Edgeworth/memepu/docs/parts.txt

74HC00 - NAND gate
74HC02 - NOR gate
74HC04 - NOT gate
74HC08 - AND gate
74HC32 - OR gate
74HC74 - D flipflop
74HC86 - XOR gate
74HC107 - Dual JK flipflop with reset, negative edge trigger.
74HC138 - 3 to 8 decoder, inverted outputs
74HC139 - 2 to 4 decoder, inverted outputs
74HC151 - 8-line to 1-line data selector/multiplexer
74HC153 - Dual 4-input data selector/multiplexer
74HC154 - 4 to 16 decoder, inverted outputs
74HC157 - select 4 bits from two data sources
74HC161 - 4 bit binary counter, synchronous, async reset
74HC193 - 4 bit binary counter, up/down, synchronous, reset
74HC238 - 3 to 8 decoder
74HC245 - Octal bidirectional bus transceiver
74HC254 - 4 to 16 decoder, inverting outputs
74HC273 - 8 bit register, asynchronous clear, bad pinout
74HC283 - 4 bit binary full adder
74HC574 - 8 bit register
74HC590 - 8 bit binary counter, tri-state
74HC595 - 8 bit shift register

Digikey costs:
x8 SRAM cost per MiB, minimum quantity 1 order, <= 10ns access time:
  32 KiB: $41.6
  128 KiB: $13.44
  256 KiB: $18.32
  512 KiB: $6.4 *
  1 MiB: $13.49
  2 MiB: $11.09

x16 SRAM cost per MiB, minimum quantity 1 order, <= 10ns access time:
  128 KiB: $14.72
  256 KiB: $11.96
  512 KiB: $5.98 *
  1 MiB: $13.14
  2 MiB: $7.87
  4 MiB: $6.375
  8 MiB: $26.75

x32 SRAM cost per MiB, minimum quantity 1 order, <= 10ns access time:
  256 KiB: $27.68
  512 MiB: $11.74
  1 MiB: $8.90 *
  2 MiB: $8.95
  4 MiB: $15
  8 MiB: $19

SDRAM: Can just buy SDRAM module off ebay?
x8 SDRAM cost per MiB, minimum quantity 1 order:
  16 MiB: $0.16
  32 MiB: $0.113
  64 MiB: $0.217

x16 SDRAM cost per MiB, minimum quantity 1 order:
  16 MiB: $0.12
  32 MiB: $0.076 *
  64 MiB: $0.20

x32 SDRAM cost per MiB, minimum quantity 1 order:
  16 MiB: $0.15
  32 MiB: $0.22
  64 MiB: $0.312

Voltage translation ICs:
GTL2003, GTL2010, GTL2000: 8 bit, 10 bit, 22 bit bi-directional translator
TXS0108: (TXB is not open-drain) 8 bit

Notes:
Arduino Nano notes:
Digital pins 0, 1 used for USB - can't use them at the same time
D13: LED
A6, 7: Can't be used as digital pins

Chips:
LM555:
Pins: Trigger, Threshold, Output, Reset, Discharge, Control voltage
Trigger: On below 1/3 * Vcc - sets SR latch and turns output on
Threshold: Once reach 2/3 * Vcc or more - resets SR latch and turns output off. Additionally connects discharge pin to ground to discharge capacitor
Reset: Disable/resets the timer. Active low. Should be set high.
Discharge: Capacitor discharges through this
Control voltage: Can modify the 2/3 * Vcc threshold value. Usually connected to ground via a bypass cap.

74HC08 - AND gate

74HC138 - 3-8 line decoder
~E1, ~E2, E3: set to enable

74HC154 - 4 to 16 line decoder:
~E1,~E2: enable inputs, tie these both low. I guess they had extra pins?

74HC161 - 4 bit synchronous counter
CEP: count enable - both CEP and CET need to be true to count
CET: input for chaining, TC => CET
TC: output for chaining. True if at highest count and about to roll-over, AND CET is high.
~PE: parallel enable input - for pre-setting values
~MR: resets all to 0, asynchronous

74HC595 - 8 bit shift register
Has a shift register and a storage register. Pulsing SRCLK reads data from SER. Pulsing RCLK outputs data from shift register onto output.
Q(a-h): Output
SER: Input bit for shifting
Qh': Output bit that comes off during a shift
SRCLK: Shift register clock (positive edge)
RCLK: Register clock (positive edge)

Functional units:
Clock:
555 timer for astable multivibrator for clock
555 timer for monostable multivibrator for manual clock
555 timer for bistable multivibrator for switch debouncing

Microop counter 74HC161:
CEP, CET: HIGH so always counts
TC: unconnected
~PE: disabled
~MR: For resetting micro op counter

Control EEPROM #2:
Input: Opcode(8), Microop counter(4)
4 pins: OUT control plane
4 pins: IN control plane
