Edgeworth/memepu/pcb/cpu/cpu.kicad_pcb

## KiCad design pcb/cpu/cpu.kicad_pcb (2021-06-20)

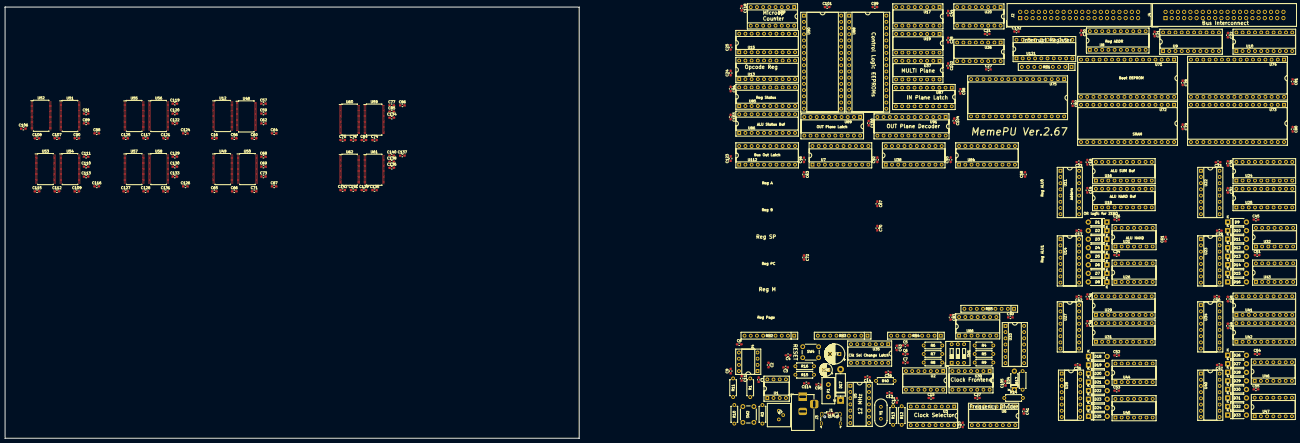
[picture p1: board cpu.kicad_pcb from above]

Board: 2 copper layers, 235.0 x 176.5 mm, 286 parts (0 on the bottom side), 340 nets, no tracks yet.

Parts:
C1, C5, C6, C7, C9, C10, C11, C14, C15, C16, C17, C18, C19, C20, C21, C22, C23, C24, C25, C26, C27, C28, C29, C30, C31, C32, C33, C34, C35, C36, C37, C38, C40, C41, C42, C43, C44, C45, C46, C47, C48, C49, C50, C51, C52, C53, C54, C55, C56, C57, C58, C59, C60, C61, C62, C63, C64, C65, C66, C67, C68, C69, C70, C71, C72, C73, C74, C75, C76, C77, C78, C79, C80, C81, C82, C83, C84, C85, C86, C87, C88, C89, C90, C91, C92, C93, C94, C98, C99, C100, C101, C102, C103, C104, C106, C107, C108, C109, C110, C111, C112, C113, C114, C115, C116, C117, C118, C119, C120, C121, C122, C123, C124, C125, C126, C127, C128, C129, C130, C131, C132, C133, C134, C135, C136, C137, C138, C139, C140, C141, C142: 0.1uF; C_0603_1608Metric_Pad1.05x0.95mm_HandSolder
C2, C3: 1uF; C_0603_1608Metric_Pad1.05x0.95mm_HandSolder
C4, C8, C105: 10nF; C_0603_1608Metric_Pad1.05x0.95mm_HandSolder
C12, C13: 27pF; C_0603_1608Metric_Pad1.05x0.95mm_HandSolder
C39: 1nF; C_0603_1608Metric_Pad1.05x0.95mm_HandSolder
C95: 10uF; C_0603_1608Metric_Pad1.05x0.95mm_HandSolder
C96: 100uF; CP_Radial_D5.0mm_P2.00mm
C97: 470uF; CP_Radial_D8.0mm_P3.80mm
D1, D2, D3, D4, D5, D6, D7, D8, D9, D10, D11, D12, D13, D14, D15, D16, D18, D19, D20, D21, D22, D23, D24, D25, D26, D27, D28, D29, D30, D31, D32, D33, D34: D; D_DO-41_SOD81_P7.62mm_Horizontal
D17: 5.6V; D_5W_P12.70mm_Horizontal
F1: 0.65A; C_Disc_D10.5mm_W5.0mm_P5.00mm
J1: Conn_01x05; USB_Micro-B_Wuerth_629105150521
J2, J4: Conn_02x20_Odd_Even; IDC-Header_2x20_P2.54mm_Vertical
J3: Conn_01x03; BarrelJack_Horizontal
R1, R3, R13: 1K; R_Axial_DIN0207_L6.3mm_D2.5mm_P7.62mm_Horizontal
R2: 1M; Akizuki-Denshi Potentiometer
R4, R5, R9, R10, R14, R15: 100K; R_Axial_DIN0207_L6.3mm_D2.5mm_P7.62mm_Horizontal
R6, R7, R8, R11, R12, R16, R17, R40: 1M; R_Axial_DIN0207_L6.3mm_D2.5mm_P7.62mm_Horizontal
RN1: 10K; R_Array_SIP9
RN2, RN3, RN4, RN5: 100K; R_Array_SIP9
SW1: SW_DIP_x03 - Clock Source Select; SW_DIP_SPSTx03_Slide_9.78x9.8mm_W7.62mm_P2.54mm
SW2, SW4: SW_Push; SW_PUSH_6mm_H7.3mm
U1: LM555; DIP-8_W7.62mm_Socket
U2: 74HC14; DIP-14_W7.62mm_Socket
U3: 74151; DIP-16_W7.62mm_Socket
U4: LM555 - Button Clock; DIP-8_W7.62mm_Socket
U5: 74HC04; DIP-14_W7.62mm_Socket
U6, U39: 74HC590; DIP-16_W7.62mm_Socket
U7, U38, U84, U87, U89, U112: 74LS574; DIP-20_W7.62mm_Socket
U8, U9, U10, U85, U121: 74HCT574; DIP-20_W7.62mm_Socket
U11, U14, U22, U23, U27, U28, U34, U40: 74LS283; DIP-16_W7.62mm_Socket
U12, U48, U49, U50, U51, U52, U53, U54, U55, U56, U57, U58, U59, U60, U61, U62: SN74LVC16374DL; TSSOP-48_6.1x12.5mm_P0.5mm
U13, U15: 74LS273; DIP-20_W7.62mm_Socket
U16, U18, U24, U25, U29, U31, U41, U42, U86: 74HC245; DIP-20_W7.62mm_Socket
U17, U19, U20, U36: 74HC238; DIP-16_W7.62mm_Socket
U21, U26, U32, U43, U44, U45, U46, U47: 74HC00; DIP-14_W7.62mm_Socket
U30: 74HC86; DIP-14_W7.62mm_Socket
U33: 74LS08; DIP-14_W7.62mm_Socket
U35: 74LS107; DIP-14_W7.62mm_Socket
U37: 74LS138; DIP-16_W7.62mm_Socket
U66: 74LS32; DIP-14_W7.62mm_Socket
U71, U88, U90: SST39SF040; DIP-32_W15.24mm_Socket
U72, U73, U74, U75: 628128; DIP-32_W15.24mm_Socket
U91: 74LS154; DIP-24_W7.62mm_Socket
Y1: 12MHz; Crystal_HC49-U_Vertical

Connections:
/ADDR0: J2.29, U8.19, U71.12
/ADDR1: J2.31, U8.18, U71.11
/ADDR2: J2.33, U8.17, U71.10, U72.12, U73.12, U74.12, U75.12
/ADDR3: J2.35, U8.16, U71.9, U72.11, U73.11, U74.11, U75.11
/ADDR4: J2.37, U8.15, U71.8, U72.10, U73.10, U74.10, U75.10
/ADDR5: J2.39, U8.14, U71.7, U72.9, U73.9, U74.9, U75.9
/ADDR6: J4.1, U8.13, U71.6, U72.8, U73.8, U74.8, U75.8
/ADDR7: J4.3, U8.12, U71.5, U72.7, U73.7, U74.7, U75.7
/ADDR8: J4.5, U9.19, U71.27, U72.6, U73.6, U74.6, U75.6
/ADDR9: J4.7, U9.18, U71.26, U72.5, U73.5, U74.5, U75.5
/ADDR10: J4.9, U9.17, U71.23, U72.27, U73.27, U74.27, U75.27
/ADDR11: J4.11, U9.16, U71.25, U72.26, U73.26, U74.26, U75.26
/ADDR12: J4.13, U9.15, U71.4, U72.23, U73.23, U74.23, U75.23
/ADDR13: J4.15, U9.14, U71.28, U72.25, U73.25, U74.25, U75.25
/ADDR14: J4.17, U9.13, U71.29, U72.4, U73.4, U74.4, U75.4
/ADDR15: J4.19, U9.12, U71.3, U72.28, U73.28, U74.28, U75.28
/ADDR16: J4.21, U10.19, U71.2, U72.3, U73.3, U74.3, U75.3
/ADDR17: J4.23, U10.18, U71.30, U72.31, U73.31, U74.31, U75.31
/ADDR18: J4.25, U10.17, U71.1, U72.2, U73.2, U74.2, U75.2
/ADDR19: J4.27, U10.16
/ADDR20: J4.29, U10.15
/ADDR21: J4.31, U10.14
/ADDR22: J4.33, U10.13, U72.22, U73.22, U74.22, U75.22
/ADDR23: J4.35, U10.12, U72.30, U73.30, U74.30, U75.30
/ADDR_IN_CLK: U8.11, U9.11, U10.11, U17.7
/ALU0_IN_CLK: U12.25, U12.48, U17.10, U48.25, U48.48
/ALU1_IN_CLK: U17.9, U49.25, U49.48, U50.25, U50.48
/ALU/A0: D1.2, U11.5, U12.2, U21.1
/ALU/A1: D2.2, U11.3, U12.3, U21.4
/ALU/A2: D3.2, U11.14, U12.5, U21.9
/ALU/A3: D4.2, U11.12, U12.6, U21.12
/ALU/A4: D5.2, U12.8, U14.5, U26.1
/ALU/A5: D6.2, U12.9, U14.3, U26.4
/ALU/A6: D7.2, U12.11, U14.14, U26.9
/ALU/A7: D8.2, U12.12, U14.12, U26.12
/ALU/A8: D9.2, U12.13, U22.5, U32.1
/ALU/A9: D10.2, U12.14, U22.3, U32.4
/ALU/A10: D11.2, U12.16, U22.14, U32.9
/ALU/A11: D12.2, U12.17, U22.12, U32.12
/ALU/A12: D13.2, U12.19, U23.5, U43.1
/ALU/A13: D14.2, U12.20, U23.3, U43.4
/ALU/A14: D15.2, U12.22, U23.14, U43.9
/ALU/A15: D16.2, U12.23, U23.12, U43.12
/ALU/A16: D18.2, U27.5, U44.1, U48.2
/ALU/A17: D19.2, U27.3, U44.4, U48.3
/ALU/A18: D20.2, U27.14, U44.9, U48.5
/ALU/A19: D21.2, U27.12, U44.12, U48.6
/ALU/A20: D22.2, U28.5, U45.1, U48.8
/ALU/A21: D23.2, U28.3, U45.4, U48.9
/ALU/A22: D24.2, U28.14, U45.9, U48.11
/ALU/A23: D25.2, U28.12, U45.12, U48.12
/ALU/A24: D26.2, U34.5, U46.1, U48.13
/ALU/A25: D27.2, U34.3, U46.4, U48.14
/ALU/A26: D28.2, U34.14, U46.9, U48.16
/ALU/A27: D29.2, U34.12, U46.12, U48.17
/ALU/A28: D30.2, U40.5, U47.1, U48.19
/ALU/A29: D31.2, U40.3, U47.4, U48.20
/ALU/A30: D32.2, U40.14, U47.9, U48.22
/ALU/A31: D33.2, U40.12, U47.12, U48.23
/ALU/B0: U11.6, U21.2, U49.2
/ALU/B1: U11.2, U21.5, U49.3
/ALU/B2: U11.15, U21.10, U49.5
/ALU/B3: U11.11, U21.13, U49.6
/ALU/B4: U14.6, U26.2, U49.8
/ALU/B5: U14.2, U26.5, U49.9
/ALU/B6: U14.15, U26.10, U49.11
/ALU/B7: U14.11, U26.13, U49.12
/ALU/B8: U22.6, U32.2, U49.13
/ALU/B9: U22.2, U32.5, U49.14
/ALU/B10: U22.15, U32.10, U49.16
/ALU/B11: U22.11, U32.13, U49.17
/ALU/B12: U23.6, U43.2, U49.19
/ALU/B13: U23.2, U43.5, U49.20
/ALU/B14: U23.15, U43.10, U49.22
/ALU/B15: U23.11, U43.13, U49.23
/ALU/B16: U27.6, U44.2, U50.2
/ALU/B17: U27.2, U44.5, U50.3
/ALU/B18: U27.15, U44.10, U50.5
/ALU/B19: U27.11, U44.13, U50.6
/ALU/B20: U28.6, U45.2, U50.8
/ALU/B21: U28.2, U45.5, U50.9
/ALU/B22: U28.15, U45.10, U50.11
/ALU/B23: U28.11, U45.13, U50.12
/ALU/B24: U34.6, U46.2, U50.13
/ALU/B25: U34.2, U46.5, U50.14
/ALU/B26: U34.15, U46.10, U50.16
/ALU/B27: U34.11, U46.13, U50.17
/ALU/B28: U40.6, U47.2, U50.19
/ALU/B29: U40.2, U47.5, U50.20
/ALU/B30: U40.15, U47.10, U50.22
/ALU/B31: U40.11, U47.13, U50.23
/ALU/CARRY0: U11.9, U14.7
/ALU/CARRY1: U14.9, U22.7
/ALU/CARRY2: U22.9, U23.7
/ALU/CARRY3: U23.9, U27.7
/ALU/CARRY4: U27.9, U28.7
/ALU/CARRY5: U28.9, U34.7
/ALU/CARRY6: U34.9, U40.7
/ALU/CARRY_OUT: U40.9, U86.2
/ALU/NAND0: U18.2, U21.3
/ALU/NAND1: U18.3, U21.6
/ALU/NAND2: U18.4, U21.8
/ALU/NAND3: U18.5, U21.11
/ALU/NAND4: U18.6, U26.3
/ALU/NAND5: U18.7, U26.6
/ALU/NAND6: U18.8, U26.8
/ALU/NAND7: U18.9, U26.11
/ALU/NAND8: U25.2, U32.3
/ALU/NAND9: U25.3, U32.6
/ALU/NAND10: U25.4, U32.8
/ALU/NAND11: U25.5, U32.11
/ALU/NAND12: U25.6, U43.3
/ALU/NAND13: U25.7, U43.6
/ALU/NAND14: U25.8, U43.8
/ALU/NAND15: U25.9, U43.11
/ALU/NAND16: U31.2, U44.3
/ALU/NAND17: U31.3, U44.6
/ALU/NAND18: U31.4, U44.8
/ALU/NAND19: U31.5, U44.11
/ALU/NAND20: U31.6, U45.3
/ALU/NAND21: U31.7, U45.6
/ALU/NAND22: U31.8, U45.8
/ALU/NAND23: U31.9, U45.11
/ALU/NAND24: U42.2, U46.3
/ALU/NAND25: U42.3, U46.6
/ALU/NAND26: U42.4, U46.8
/ALU/NAND27: U42.5, U46.11
/ALU/NAND28: U42.6, U47.3
/ALU/NAND29: U42.7, U47.6
/ALU/NAND30: U42.8, U47.8
/ALU/NAND31: U42.9, U47.11
/ALU/SUM0: U11.4, U16.2
/ALU/SUM1: U11.1, U16.3
/ALU/SUM2: U11.13, U16.4
/ALU/SUM3: U11.10, U16.5
/ALU/SUM4: U14.4, U16.6
/ALU/SUM5: U14.1, U16.7
/ALU/SUM6: U14.13, U16.8
/ALU/SUM7: U14.10, U16.9
/ALU/SUM8: U22.4, U24.2
/ALU/SUM9: U22.1, U24.3
/ALU/SUM10: U22.13, U24.4
/ALU/SUM11: U22.10, U24.5
/ALU/SUM12: U23.4, U24.6
/ALU/SUM13: U23.1, U24.7
/ALU/SUM14: U23.13, U24.8
/ALU/SUM15: U23.10, U24.9
/ALU/SUM16: U27.4, U29.2
/ALU/SUM17: U27.1, U29.3
/ALU/SUM18: U27.13, U29.4
/ALU/SUM19: U27.10, U29.5
/ALU/SUM20: U28.4, U29.6
/ALU/SUM21: U28.1, U29.7
/ALU/SUM22: U28.13, U29.8
/ALU/SUM23: U28.10, U29.9
/ALU/SUM24: U34.4, U41.2
/ALU/SUM25: U34.1, U41.3
/ALU/SUM26: U34.13, U41.4
/ALU/SUM27: U34.10, U41.5
/ALU/SUM28: U40.4, U41.6
/ALU/SUM29: U40.1, U41.7
/ALU/SUM30: U40.13, U41.8
/ALU/SUM31: U40.10, U41.9
/ALU/ZERO_OUT: U2.8, U86.3
/A_IN_CLK: U17.14, U51.25, U51.48, U52.25, U52.48
/BUS0: J2.2, RN2.9, U8.2, U12.47, U13.3, U15.3, U16.18, U18.18, U49.47, U51.2, U51.47, U53.2, U53.47, U55.2, U55.47, U57.2, U57.47, U59.2, U59.47, U61.2, U61.47, U71.13, U72.13, U85.2, U85.19, U86.18, U112.19, U121.19
/BUS1: J2.4, RN2.8, U8.3, U12.46, U13.4, U15.4, U16.17, U18.17, U49.46, U51.3, U51.46, U53.3, U53.46, U55.3, U55.46, U57.3, U57.46, U59.3, U59.46, U61.3, U61.46, U71.14, U72.14, U85.3, U85.18, U86.17, U112.18, U121.18
/BUS2: J2.6, RN2.7, U8.4, U12.44, U13.7, U15.7, U16.16, U18.16, U49.44, U51.5, U51.44, U53.5, U53.44, U55.5, U55.44, U57.5, U57.44, U59.5, U59.44, U61.5, U61.44, U71.15, U72.15, U85.4, U85.17, U86.16, U112.17, U121.17
/BUS3: J2.8, RN2.6, U8.5, U12.43, U13.8, U15.8, U16.15, U18.15, U49.43, U51.6, U51.43, U53.6, U53.43, U55.6, U55.43, U57.6, U57.43, U59.6, U59.43, U61.6, U61.43, U71.17, U72.17, U85.5, U85.16, U86.15, U112.16, U121.16
/BUS4: J2.10, RN2.5, U8.6, U12.41, U13.13, U15.13, U16.14, U18.14, U49.41, U51.8, U51.41, U53.8, U53.41, U55.8, U55.41, U57.8, U57.41, U59.8, U59.41, U61.8, U61.41, U71.18, U72.18, U85.6, U85.15, U86.14, U112.15, U121.15
/BUS5: J2.12, RN2.4, U8.7, U12.40, U13.14, U15.14, U16.13, U18.13, U49.40, U51.9, U51.40, U53.9, U53.40, U55.9, U55.40, U57.9, U57.40, U59.9, U59.40, U61.9, U61.40, U71.19, U72.19, U85.7, U85.14, U86.13, U112.14, U121.14
/BUS6: J2.14, RN2.3, U8.8, U12.38, U13.17, U15.17, U16.12, U18.12, U49.38, U51.11, U51.38, U53.11, U53.38, U55.11, U55.38, U57.11, U57.38, U59.11, U59.38, U61.11, U61.38, U71.20, U72.20, U85.8, U85.13, U86.12, U112.13, U121.13
/BUS7: J2.16, RN2.2, U8.9, U12.37, U13.18, U15.18, U16.11, U18.11, U49.37, U51.12, U51.37, U53.12, U53.37, U55.12, U55.37, U57.12, U57.37, U59.12, U59.37, U61.12, U61.37, U71.21, U72.21, U85.9, U85.12, U86.11, U112.12, U121.12
/BUS8: J2.18, RN3.9, U7.19, U9.2, U12.36, U24.18, U25.18, U49.36, U51.13, U51.36, U53.13, U53.36, U55.13, U55.36, U57.13, U57.36, U59.13, U59.36, U61.13, U61.36, U73.13
/BUS9: J2.20, RN3.8, U7.18, U9.3, U12.35, U24.17, U25.17, U49.35, U51.14, U51.35, U53.14, U53.35, U55.14, U55.35, U57.14, U57.35, U59.14, U59.35, U61.14, U61.35, U73.14
/BUS10: J2.22, RN3.7, U7.17, U9.4, U12.33, U24.16, U25.16, U49.33, U51.16, U51.33, U53.16, U53.33, U55.16, U55.33, U57.16, U57.33, U59.16, U59.33, U61.16, U61.33, U73.15
/BUS11: J2.24, RN3.6, U7.16, U9.5, U12.32, U24.15, U25.15, U49.32, U51.17, U51.32, U53.17, U53.32, U55.17, U55.32, U57.17, U57.32, U59.17, U59.32, U61.17, U61.32, U73.17
/BUS12: J2.26, RN3.5, U7.15, U9.6, U12.30, U24.14, U25.14, U49.30, U51.19, U51.30, U53.19, U53.30, U55.19, U55.30, U57.19, U57.30, U59.19, U59.30, U61.19, U61.30, U73.18
/BUS13: J2.28, RN3.4, U7.14, U9.7, U12.29, U24.13, U25.13, U49.29, U51.20, U51.29, U53.20, U53.29, U55.20, U55.29, U57.20, U57.29, U59.20, U59.29, U61.20, U61.29, U73.19
/BUS14: J2.30, RN3.3, U7.13, U9.8, U12.27, U24.12, U25.12, U49.27, U51.22, U51.27, U53.22, U53.27, U55.22, U55.27, U57.22, U57.27, U59.22, U59.27, U61.22, U61.27, U73.20
/BUS15: J2.32, RN3.2, U7.12, U9.9, U12.26, U24.11, U25.11, U49.26, U51.23, U51.26, U53.23, U53.26, U55.23, U55.26, U57.23, U57.26, U59.23, U59.26, U61.23, U61.26, U73.21
/BUS16: J2.34, RN4.9, U10.2, U29.18, U31.18, U38.19, U48.47, U50.47, U52.2, U52.47, U54.2, U54.47, U56.2, U56.47, U58.2, U58.47, U60.2, U60.47, U62.2, U62.47, U74.13
/BUS17: J2.36, RN4.8, U10.3, U29.17, U31.17, U38.18, U48.46, U50.46, U52.3, U52.46, U54.3, U54.46, U56.3, U56.46, U58.3, U58.46, U60.3, U60.46, U62.3, U62.46, U74.14
/BUS18: J2.38, RN4.7, U10.4, U29.16, U31.16, U38.17, U48.44, U50.44, U52.5, U52.44, U54.5, U54.44, U56.5, U56.44, U58.5, U58.44, U60.5, U60.44, U62.5, U62.44, U74.15
/BUS19: J2.40, RN4.6, U10.5, U29.15, U31.15, U38.16, U48.43, U50.43, U52.6, U52.43, U54.6, U54.43, U56.6, U56.43, U58.6, U58.43, U60.6, U60.43, U62.6, U62.43, U74.17
/BUS20: J4.2, RN4.5, U10.6, U29.14, U31.14, U38.15, U48.41, U50.41, U52.8, U52.41, U54.8, U54.41, U56.8, U56.41, U58.8, U58.41, U60.8, U60.41, U62.8, U62.41, U74.18
/BUS21: J4.4, RN4.4, U10.7, U29.13, U31.13, U38.14, U48.40, U50.40, U52.9, U52.40, U54.9, U54.40, U56.9, U56.40, U58.9, U58.40, U60.9, U60.40, U62.9, U62.40, U74.19
/BUS22: J4.6, RN4.3, U10.8, U29.12, U31.12, U38.13, U48.38, U50.38, U52.11, U52.38, U54.11, U54.38, U56.11, U56.38, U58.11, U58.38, U60.11, U60.38, U62.11, U62.38, U74.20
/BUS23: J4.8, RN4.2, U10.9, U29.11, U31.11, U38.12, U48.37, U50.37, U52.12, U52.37, U54.12, U54.37, U56.12, U56.37, U58.12, U58.37, U60.12, U60.37, U62.12, U62.37, U74.21
/BUS24: J4.10, RN5.9, U41.18, U42.18, U48.36, U50.36, U52.13, U52.36, U54.13, U54.36, U56.13, U56.36, U58.13, U58.36, U60.13, U60.36, U62.13, U62.36, U75.13, U84.19
/BUS25: J4.12, RN5.8, U41.17, U42.17, U48.35, U50.35, U52.14, U52.35, U54.14, U54.35, U56.14, U56.35, U58.14, U58.35, U60.14, U60.35, U62.14, U62.35, U75.14, U84.18
/BUS26: J4.14, RN5.7, U41.16, U42.16, U48.33, U50.33, U52.16, U52.33, U54.16, U54.33, U56.16, U56.33, U58.16, U58.33, U60.16, U60.33, U62.16, U62.33, U75.15, U84.17
/BUS27: J4.16, RN5.6, U41.15, U42.15, U48.32, U50.32, U52.17, U52.32, U54.17, U54.32, U56.17, U56.32, U58.17, U58.32, U60.17, U60.32, U62.17, U62.32, U75.17, U84.16
/BUS28: J4.18, RN5.5, U41.14, U42.14, U48.30, U50.30, U52.19, U52.30, U54.19, U54.30, U56.19, U56.30, U58.19, U58.30, U60.19, U60.30, U62.19, U62.30, U75.18, U84.15
/BUS29: J4.20, RN5.4, U41.13, U42.13, U48.29, U50.29, U52.20, U52.29, U54.20, U54.29, U56.20, U56.29, U58.20, U58.29, U60.20, U60.29, U62.20, U62.29, U75.19, U84.14
/BUS30: J4.22, RN5.3, U41.12, U42.12, U48.27, U50.27, U52.22, U52.27, U54.22, U54.27, U56.22, U56.27, U58.22, U58.27, U60.22, U60.27, U62.22, U62.27, U75.20, U84.13
/BUS31: J4.24, RN5.2, U41.11, U42.11, U48.26, U50.26, U52.23, U52.26, U54.23, U54.26, U56.23, U56.26, U58.23, U58.26, U60.23, U60.26, U62.23, U62.26, U75.21, U84.12
/B_IN_CLK: U17.13, U53.25, U53.48, U54.25, U54.48
/CARRY_IN: U11.7, U37.12
/CLK: J2.5, U5.13, U17.6, U33.3, U39.11, U39.13
/Clock/1.5MHZ_CLK: U3.1, U6.2
/Clock/3MHZ_CLK: U3.2, U6.1
/Clock/6MHZ_CLK: U3.3, U6.15
/Clock/12MHZ_CLK: U3.4, U5.4, U6.11, U6.13
/Clock/47_KHZ_CLK: U3.14, U6.7
/Clock/187KHZ_CLK: U3.15, U6.5
/Clock/AC_TR: C3.1, R2.2, U1.2, U1.6
/Clock/ADJ_CLK: U1.3, U3.13
/Clock/BTN_CLK: U3.12, U4.3
/Clock/PRE_CLK: U3.5, U33.10, U35.9
/Clock/SEL0: U2.2, U3.11, U30.1
/Clock/SEL1: U2.4, U3.10, U30.2
/Clock/SEL2: U2.6, U3.9, U30.12
/Control Logic/CTRL0: U87.2, U88.13
/Control Logic/CTRL1: U87.3, U88.14
/Control Logic/CTRL2: U87.4, U88.15
/Control Logic/CTRL3: U87.5, U88.17
/Control Logic/CTRL4: U87.6, U88.18
/Control Logic/CTRL5: U87.7, U88.19
/Control Logic/CTRL6: U87.8, U88.20
/Control Logic/CTRL7: U87.9, U88.21
/Control Logic/CTRL8: U7.2, U38.2, U84.2, U89.2, U90.13, U112.2
/Control Logic/CTRL9: U7.3, U38.3, U84.3, U89.3, U90.14, U112.3
/Control Logic/CTRL10: U7.4, U38.4, U84.4, U89.4, U90.15, U112.4
/Control Logic/CTRL11: U7.5, U38.5, U84.5, U89.5, U90.17, U112.5
/Control Logic/CTRL12: U7.6, U38.6, U84.6, U89.6, U90.18, U112.6
/Control Logic/CTRL13: U7.7, U38.7, U84.7, U89.7, U90.19, U112.7
/Control Logic/CTRL14: U7.8, U38.8, U84.8, U89.8, U90.20, U112.8
/Control Logic/CTRL15: U7.9, U38.9, U84.9, U89.9, U90.21, U112.9
/Control Logic/CTRL_IN0: U17.1, U19.1, U20.1, U36.1, U87.19
/Control Logic/CTRL_IN1: U17.2, U19.2, U20.2, U36.2, U87.18
/Control Logic/CTRL_IN2: U17.3, U19.3, U20.3, U36.3, U87.17
/Control Logic/CTRL_IN3: U17.4, U19.6, U20.5, U36.6, U87.16
/Control Logic/CTRL_IN4: U5.11, U17.5, U19.5, U20.6, U87.15
/Control Logic/CTRL_MULTI0: U37.1, U87.14
/Control Logic/CTRL_MULTI1: U37.2, U87.13
/Control Logic/CTRL_MULTI2: U37.3, U87.12, U91.18
/Control Logic/CTRL_OUT0: U89.19, U91.23
/Control Logic/CTRL_OUT1: U89.18, U91.22
/Control Logic/CTRL_OUT2: U89.17, U91.21
/Control Logic/CTRL_OUT3: U89.16, U91.20
/Control Logic/IN decoder/~S4: U5.10, U36.5
/Control Logic/MICROOP0: U39.15, U88.29, U90.29
/Control Logic/MICROOP1: U39.1, U88.3, U90.3
/Control Logic/MICROOP2: U39.2, U88.2, U90.2
/Control Logic/MICROOP3: U39.3, U88.30, U90.30
/Control Logic/MICROOP4: U39.4, U88.1, U90.1
/Control Logic/MMU_IN_CLK: U5.9, U19.15
/Control Logic/OP0: U13.2, U88.12, U90.12
/Control Logic/OP1: U13.5, U88.11, U90.11
/Control Logic/OP2: U13.6, U88.10, U90.10
/Control Logic/OP3: U13.9, U88.9, U90.9
/Control Logic/OP4: U13.12, U88.8, U90.8
/Control Logic/OP5: U13.15, U88.7, U90.7
/Control Logic/OP6: U13.16, U88.6, U90.6
/Control Logic/OP7: U13.19, U88.5, U90.5
/Control Logic/OP8: U15.2, U88.27, U90.27
/Control Logic/OP9: U15.5, U88.26, U90.26
/Control Logic/OP10: U15.6, U88.23, U90.23
/Control Logic/OP11: U15.9, U88.25, U90.25
/Control Logic/OP12: U15.12, U88.4, U90.4
/Control Logic/OP13: U15.15, U88.28, U90.28
/Control Logic/OPCODE0_IN_CLK: U13.11, U20.14
/Control Logic/OPCODE1_IN_CLK: U15.11, U20.13
/Control Logic/~BUS0_OUT_NCLK: U37.11, U112.1
/Control Logic/~BUS1_OUT_NCLK: U7.1, U37.10
/Control Logic/~BUS2_OUT_NCLK: U37.9, U38.1
/Control Logic/~BUS3_OUT_NCLK: U37.7, U84.1
/Control Logic/~RESET_UOP_COUNT_NCLK: U37.13, U39.10
/INT0: J2.13, RN1.9, U121.2
/INT1: J2.15, RN1.8, U121.3
/INT2: J2.17, RN1.7, U121.4
/INT3: J2.19, RN1.6, U121.5
/INT4: J2.21, RN1.5, U121.6
/INT5: J2.23, RN1.4, U121.7
/INT6: J2.25, RN1.3, U121.8
/INT7: J2.27, RN1.2, U121.9
/INT_IN_CLK: U20.15, U121.11
/M0_IN_CLK: U19.13, U66.2
/M1_IN_CLK: U19.12, U66.5
/M2_IN_CLK: U19.11, U66.10
/M3_IN_CLK: U19.10, U66.13
/M_IN_CLK: U19.14, U66.1, U66.4, U66.9, U66.12
/PAGE_IN_CLK: U19.9, U61.25, U61.48, U62.25, U62.48
/PC_IN_CLK: U17.11, U57.25, U57.48, U58.25, U58.48
/Registers/Register M/REG_IN0_OR: U59.48, U66.3
/Registers/Register M/REG_IN1_OR: U59.25, U66.6
/Registers/Register M/REG_IN2_OR: U60.48, U66.8
/Registers/Register M/REG_IN3_OR: U60.25, U66.11
/SP_IN_CLK: U17.12, U55.25, U55.48, U56.25, U56.48
/STATUS_IN_CLK: U19.7, U85.11
/~ALU_STATUS_OUT_NCLK: U86.19, U91.15
/~A_OUT_NCLK: U51.1, U51.24, U52.1, U52.24, U91.2
/~B_OUT_NCLK: U53.1, U53.24, U54.1, U54.24, U91.3
/~CLK: J2.7, U5.12, U7.11, U19.4, U20.4, U36.4, U38.11, U84.11, U87.11, U89.11, U112.11
/~EEPROM_OUT_NCLK: U71.24, U91.11
/~INT_OUT_NCLK: U91.9, U121.1
/~MMU_IN_CLK: J2.9, U5.8, U72.29, U73.29, U74.29, U75.29
/~MMU_OUT_NCLK: J2.11, U72.24, U73.24, U74.24, U75.24, U91.8
/~M_OUT_NCLK: U59.1, U59.24, U60.1, U60.24, U91.13
/~NAND_OUT_NCLK: U18.19, U25.19, U31.19, U42.19, U91.7
/~PAGE_OUT_NCLK: U61.1, U61.24, U62.1, U62.24, U91.14
/~PC_OUT_NCLK: U57.1, U57.24, U58.1, U58.24, U91.5
/~RESET: U13.1, U15.1, U30.13, U33.6
/~RESET_NCLK: U33.5, U37.14
/~SP_OUT_NCLK: U55.1, U55.24, U56.1, U56.24, U91.4
/~STATUS_OUT_NCLK: U85.1, U91.10
/~SUM_OUT_NCLK: U16.19, U24.19, U29.19, U41.19, U91.6
GND: C1.2, C2.1, C3.2, C4.2, C5.1, C6.1, C7.1, C8.2, C9.2, C10.2, C11.1, C12.2, C13.2, C14.2, C15.1, C16.2, C17.2, C18.2, C19.2, C20.2, C21.2, C22.2, C23.2, C24.1, C25.1, C26.2, C27.1, C28.1, C29.2, C30.2, C31.1, C32.2, C33.2, C34.2, C35.2, C36.2, C37.1, C38.2, C39.2, C40.1, C41.1, C42.2, C43.1, C44.1, C45.2, C46.1, C47.2, C48.2, C49.2, C50.2, C51.2, C52.2, C53.2, C54.2, C55.2, C56.2, C57.2, C58.2, C59.2, C60.2, C61.2, C62.2, C63.2, C64.2, C65.2, C66.2, C67.2, C68.2, C69.2, C70.2, C71.2, C72.2, C73.2, C74.2, C75.2, C76.2, C77.2, C78.1, C79.1, C80.1, C81.1, C82.1, C83.2, C84.2, C85.2, C86.2, C87.2, C88.2, C89.2, C90.2, C91.2, C92.1, C93.1, C94.2, C95.2, C96.2, C97.2, C98.1, C99.1, C100.1, C101.1, C102.1, C103.2, C104.1, C105.1, C106.2, C107.2, C108.2, C109.2, C110.2, C111.2, C112.2, C113.2, C114.1, C115.2, C116.2, C117.2, C118.1, C119.2, C120.2, C121.2, C122.2, C123.1, C124.2, C125.2, C126.2, C127.2, C128.2, C129.2, C130.2, C131.2, C132.2, C133.2, C134.2, C135.2, C136.2, C137.2, C138.2, C139.2, C140.2, C141.2, C142.2, D17.2, J1.5, J2.3, J3.2, R14.1, R15.2, RN1.1, RN2.1, RN3.1, RN4.1, RN5.1, SW1.1, SW1.2, SW1.3, SW2.1, U1.1, U2.7, U3.7, U3.8, U4.1, U5.7, U6.8, U6.12, U6.14, U7.10, U8.1, U8.10, U9.1, U9.10, U10.1, U10.10, U11.8, U12.1, U12.4, U12.10, U12.15, U12.21, U12.24, U12.28, U12.34, U12.39, U12.45, U13.10, U14.8, U15.10, U16.10, U17.8, U18.10, U19.8, U20.8, U21.7, U22.8, U23.8, U24.10, U25.10, U26.7, U27.8, U28.8, U29.10, U30.7, U31.10, U32.7, U33.7, U33.12, U33.13, U34.8, U35.1, U35.4, U35.7, U35.12, U35.13, U36.8, U37.4, U37.5, U37.8, U38.10, U39.8, U39.12, U39.14, U40.8, U41.10, U42.10, U43.7, U44.7, U45.7, U46.7, U47.7, U48.1, U48.4, U48.10, U48.15, U48.21, U48.24, U48.28, U48.34, U48.39, U48.45, U49.1, U49.4, U49.10, U49.15, U49.21, U49.24, U49.28, U49.34, U49.39, U49.45, U50.1, U50.4, U50.10, U50.15, U50.21, U50.24, U50.28, U50.34, U50.39, U50.45, U51.4, U51.10, U51.15, U51.21, U51.28, U51.34, U51.39, U51.45, U52.4, U52.10, U52.15, U52.21, U52.28, U52.34, U52.39, U52.45, U53.4, U53.10, U53.15, U53.21, U53.28, U53.34, U53.39, U53.45, U54.4, U54.10, U54.15, U54.21, U54.28, U54.34, U54.39, U54.45, U55.4, U55.10, U55.15, U55.21, U55.28, U55.34, U55.39, U55.45, U56.4, U56.10, U56.15, U56.21, U56.28, U56.34, U56.39, U56.45, U57.4, U57.10, U57.15, U57.21, U57.28, U57.34, U57.39, U57.45, U58.4, U58.10, U58.15, U58.21, U58.28, U58.34, U58.39, U58.45, U59.4, U59.10, U59.15, U59.21, U59.28, U59.34, U59.39, U59.45, U60.4, U60.10, U60.15, U60.21, U60.28, U60.34, U60.39, U60.45, U61.4, U61.10, U61.15, U61.21, U61.28, U61.34, U61.39, U61.45, U62.4, U62.10, U62.15, U62.21, U62.28, U62.34, U62.39, U62.45, U66.7, U71.16, U71.22, U72.16, U73.16, U74.16, U75.16, U84.10, U85.10, U86.4, U86.5, U86.6, U86.7, U86.8, U86.9, U86.10, U87.1, U87.10, U88.16, U88.22, U88.24, U89.1, U89.10, U90.16, U90.22, U90.24, U91.12, U91.19, U112.10, U121.10
unnamed: C4.1, U1.5
unnamed: C5.2, R6.1, U2.1
unnamed: C6.2, R7.1, U2.3
unnamed: C7.2, R8.1, U2.5
unnamed: C8.1, U4.5
unnamed: C11.2, R11.2, U4.6, U4.7
unnamed: C12.1, R12.2, U5.1, Y1.1
unnamed: C13.1, R13.2, Y1.2
unnamed: C39.1, R40.1, U2.11
unnamed: C105.2, D34.2, R17.2, U33.9
unnamed: C114.2, R16.1, U2.13
unnamed: D1.1, D2.1, D3.1, D4.1, D5.1, D6.1, D7.1, D8.1, D9.1, D10.1, D11.1, D12.1, D13.1, D14.1, D15.1, D16.1, D18.1, D19.1, D20.1, D21.1, D22.1, D23.1, D24.1, D25.1, D26.1, D27.1, D28.1, D29.1, D30.1, D31.1, D32.1, D33.1, U2.9
unnamed: F1.1, J1.1, J3.1
unnamed: R1.2, R3.1, U1.7
unnamed: R2.1, R3.2
unnamed: R4.2, R6.2, SW1.6
unnamed: R5.2, R7.2, SW1.5
unnamed: R8.2, R9.2, SW1.4
unnamed: R10.1, SW2.2, U4.2
unnamed: R12.1, R13.1, U5.2, U5.3
unnamed: R15.1, R16.2, SW4.1
unnamed: R40.2, U30.9, U35.5
unnamed: U2.10, U30.10
unnamed: U2.12, U33.4
unnamed: U30.3, U30.4
unnamed: U5.5, U30.6, U35.8
unnamed: U30.8, U33.2
unnamed: U30.5, U30.11
unnamed: U33.1, U33.8
unnamed: U5.6, U35.11
VCC: C1.1, C2.2, C9.1, C10.1, C14.1, C15.2, C16.1, C17.1, C18.1, C19.1, C20.1, C21.1, C22.1, C23.1, C24.2, C25.2, C26.1, C27.2, C28.2, C29.1, C30.1, C31.2, C32.1, C33.1, C34.1, C35.1, C36.1, C37.2, C38.1, C40.2, C41.2, C42.1, C43.2, C44.2, C45.1, C46.2, C47.1, C48.1, C49.1, C50.1, C51.1, C52.1, C53.1, C54.1, C55.1, C56.1, C57.1, C58.1, C59.1, C60.1, C61.1, C62.1, C63.1, C64.1, C65.1, C66.1, C67.1, C68.1, C69.1, C70.1, C71.1, C72.1, C73.1, C74.1, C75.1, C76.1, C77.1, C78.2, C79.2, C80.2, C81.2, C82.2, C83.1, C84.1, C85.1, C86.1, C87.1, C88.1, C89.1, C90.1, C91.1, C92.2, C93.2, C94.1, C95.1, C96.1, C97.1, C98.2, C99.2, C100.2, C101.2, C102.2, C103.1, C104.2, C106.1, C107.1, C108.1, C109.1, C110.1, C111.1, C112.1, C113.1, C115.1, C116.1, C117.1, C118.2, C119.1, C120.1, C121.1, C122.1, C123.2, C124.1, C125.1, C126.1, C127.1, C128.1, C129.1, C130.1, C131.1, C132.1, C133.1, C134.1, C135.1, C136.1, C137.1, C138.1, C139.1, C140.1, C141.1, C142.1, D17.1, D34.1, F1.2, J2.1, R1.1, R4.1, R5.1, R9.1, R10.2, R11.1, R14.2, R17.1, SW4.2, U1.4, U1.8, U2.14, U3.16, U4.4, U4.8, U5.14, U6.10, U6.16, U7.20, U8.20, U9.20, U10.20, U11.16, U12.7, U12.18, U12.31, U12.42, U13.20, U14.16, U15.20, U16.1, U16.20, U17.16, U18.1, U18.20, U19.16, U20.16, U21.14, U22.16, U23.16, U24.1, U24.20, U25.1, U25.20, U26.14, U27.16, U28.16, U29.1, U29.20, U30.14, U31.1, U31.20, U32.14, U33.14, U34.16, U35.10, U35.14, U36.16, U37.6, U37.16, U38.20, U39.16, U40.16, U41.1, U41.20, U42.1, U42.20, U43.14, U44.14, U45.14, U46.14, U47.14, U48.7, U48.18, U48.31, U48.42, U49.7, U49.18, U49.31, U49.42, U50.7, U50.18, U50.31, U50.42, U51.7, U51.18, U51.31, U51.42, U52.7, U52.18, U52.31, U52.42, U53.7, U53.18, U53.31, U53.42, U54.7, U54.18, U54.31, U54.42, U55.7, U55.18, U55.31, U55.42, U56.7, U56.18, U56.31, U56.42, U57.7, U57.18, U57.31, U57.42, U58.7, U58.18, U58.31, U58.42, U59.7, U59.18, U59.31, U59.42, U60.7, U60.18, U60.31, U60.42, U61.7, U61.18, U61.31, U61.42, U62.7, U62.18, U62.31, U62.42, U66.14, U71.31, U71.32, U72.32, U73.32, U74.32, U75.32, U84.20, U85.20, U86.1, U86.20, U87.20, U88.31, U88.32, U89.20, U90.31, U90.32, U91.24, U112.20, U121.20
