Edgeworth/memepu/pcb/dram_test/dram_test.kicad_pcb

## KiCad design pcb/dram_test/dram_test.kicad_pcb (2019-04-19)

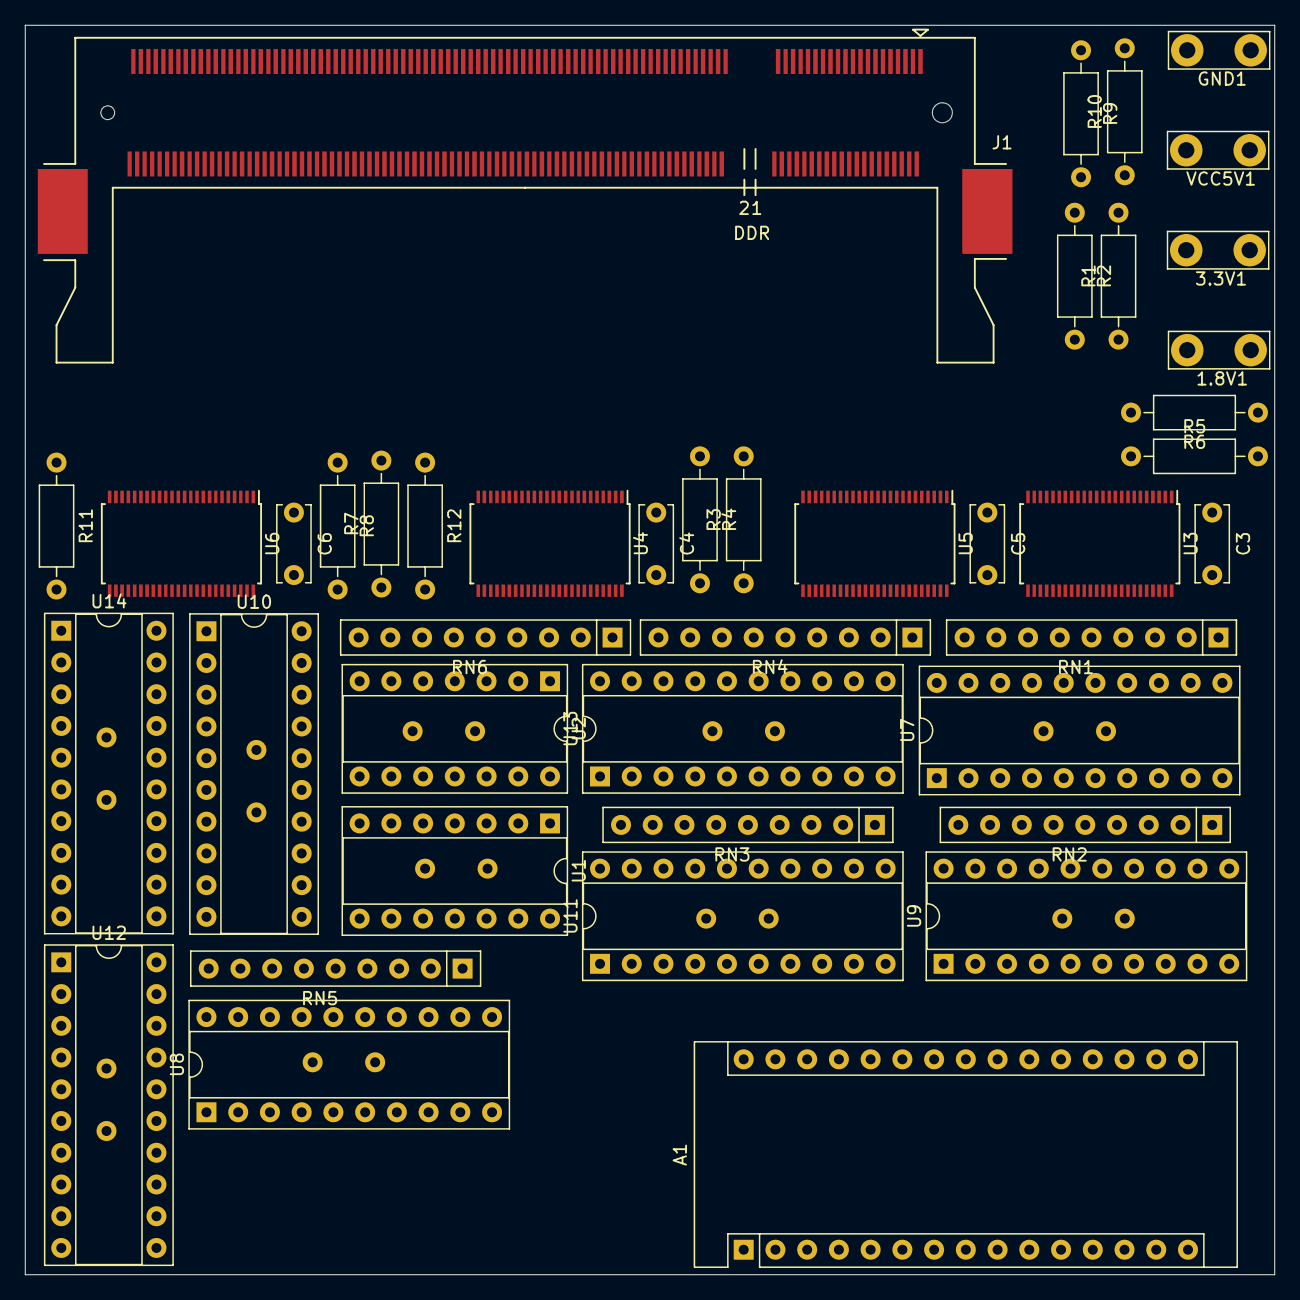
[picture p2: board dram_test.kicad_pcb from above]

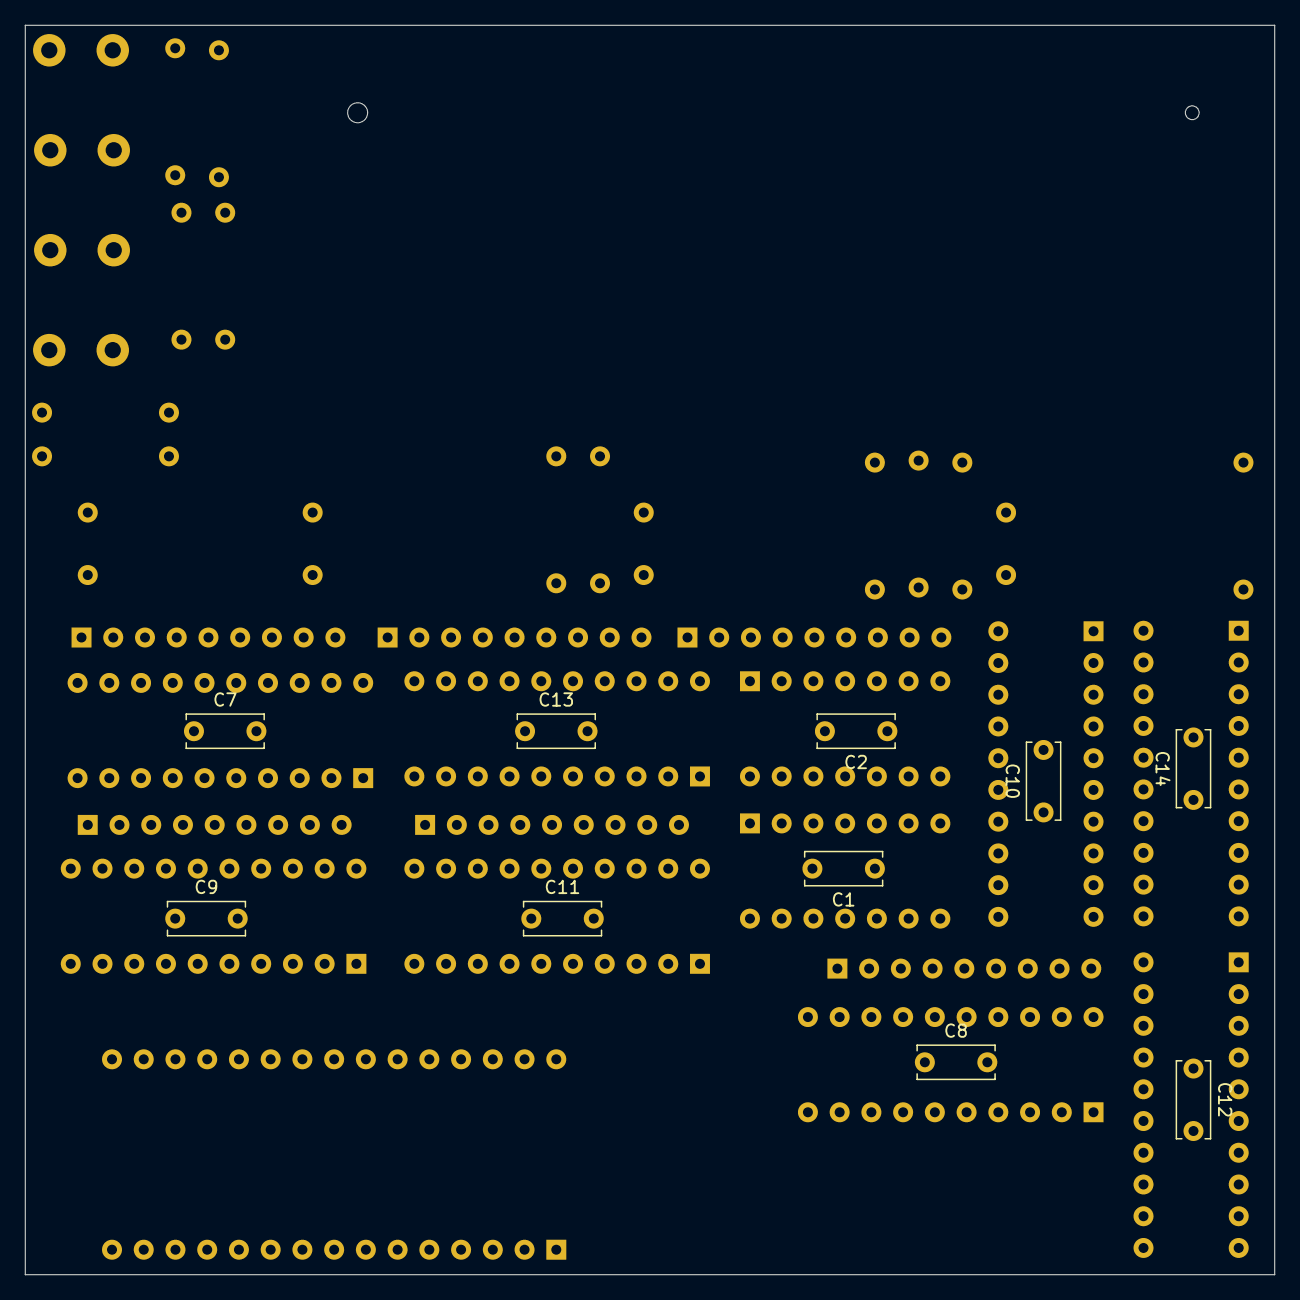
[picture p3: board dram_test.kicad_pcb from below]

Board: 2 copper layers, 100.0 x 100.0 mm, 52 parts (10 on the bottom side), 193 nets, no tracks yet.

Parts:
1.8V1, 3.3V1: TestPoint; TestPoint_Bridge_Pitch5.08mm_Drill1.3mm
A1: Arduino_Nano_v3.x; Arduino_Nano
C1, C2, C3, C4, C5, C6, C7, C8, C9, C10, C11, C12, C13, C14: 0.1uF; C_Disc_D6.0mm_W2.5mm_P5.00mm
GND1: TestPoint; TestPoint_Bridge_Pitch5.08mm_Drill1.3mm
J1: SODIMM-200; Socket_SODIMM_DDR1-2_TE_1612618
R1, R2, R3, R4, R5, R6, R7, R8, R12: 100K; R_Axial_DIN0207_L6.3mm_D2.5mm_P10.16mm_Horizontal
R9, R10, R11: 10K; R_Axial_DIN0207_L6.3mm_D2.5mm_P10.16mm_Horizontal
RN1, RN2, RN3, RN4, RN5, RN6: 100K; R_Array_SIP9
U1, U2: 74HC04; DIP-14_W7.62mm_Socket
U3, U4, U5, U6: GTL2000; TSSOP-48_6.1x12.5mm_P0.5mm
U7, U8, U9, U10, U11, U12, U13, U14: 74LS299; DIP-20_W7.62mm_Socket
VCC5V1: TestPoint; TestPoint_Bridge_Pitch5.08mm_Drill1.3mm

Connections:
+1V8: 1.8V1.1, J1.81, J1.82, J1.87, J1.88, J1.95, J1.96, J1.103, J1.104, J1.111, J1.112, J1.117, J1.118, R9.1, U3.2, U4.2, U5.2, U6.2
/A0: J1.102, U4.15
/A1: J1.101, U4.16
/A2: J1.100, U4.17
/A3: J1.99, U4.18
/A4: J1.98, U4.19
/A5: J1.97, U4.20
/A6: J1.94, U4.21
/A7: J1.92, U4.22
/A8: J1.93, U4.23
/A9: J1.91, U4.24
/A10AP: J1.105, U6.3
/A11: J1.90, U6.4
/A12: J1.89, U6.5
/A13: J1.116, U6.6
/BA0: J1.107, U6.7
/BA1: J1.106, U6.8
/BA2: J1.85, U6.9
/CK0: J1.30, U4.7
/CK1: J1.164, U4.9
/DM0: J1.10, U4.11
/DM1: J1.26, U4.12
/DM2: J1.52, U4.13
/DM3: J1.67, U4.14
/DQ0: J1.5, U3.3
/DQ1: J1.7, U3.4
/DQ2: J1.17, U3.5
/DQ3: J1.19, U3.6
/DQ4: J1.4, U3.7
/DQ5: J1.6, U3.8
/DQ6: J1.14, U3.9
/DQ7: J1.16, U3.10
/DQ8: J1.23, U3.11
/DQ9: J1.25, U3.12
/DQ10: J1.35, U3.13
/DQ11: J1.37, U3.14
/DQ12: J1.20, U3.15
/DQ13: J1.22, U3.16
/DQ14: J1.36, U3.17
/DQ15: J1.38, U3.18
/DQ16: J1.43, U3.19
/DQ17: J1.45, U3.20
/DQ18: J1.55, U3.21
/DQ19: J1.57, U3.22
/DQ20: J1.44, U3.23
/DQ21: J1.46, U3.24
/DQ22: J1.56, U5.3
/DQ23: J1.58, U5.4
/DQ24: J1.61, U5.5
/DQ25: J1.63, U5.6
/DQ26: J1.73, U5.7
/DQ27: J1.75, U5.8
/DQ28: J1.62, U5.9
/DQ29: J1.64, U5.10
/DQ30: J1.74, U5.11
/DQ31: J1.76, U5.12
/DQS0: J1.13, U5.13
/DQS1: J1.31, U5.15
/DQS2: J1.51, U5.17
/DQS3: J1.70, U5.19
/DQS4: J1.131, U5.21
/DQS5: J1.148, U5.23
/DQS6: J1.169, U4.3
/DQS7: J1.188, U4.5
/NC: J1.69, J1.83, J1.84, J1.86, J1.120, J1.163
/ODT1: J1.119, U6.19
/PREA0: U4.34, U10.5
/PREA1: U4.33, U10.15
/PREA2: U4.32, U10.4
/PREA3: U4.31, U10.16
/PREA4: U4.30, U12.7
/PREA5: U4.29, U12.13
/PREA6: U4.28, U12.6
/PREA7: U4.27, U12.14
/PREA8: U4.26, U12.5
/PREA9: U4.25, U12.15
/PREA10: U6.46, U12.4
/PREA11: U6.45, U12.16
/PREA12: U6.44, U14.7
/PREA13: U6.43, U14.13
/PREBA0: U6.42, U14.6
/PREBA1: U6.41, U14.14
/PREBA2: U6.40, U14.5
/PRECK0: A1.19, U1.1, U4.42
/PRECK1: A1.20, U1.3, U4.40
/PREDM0: U4.38, U10.7
/PREDM1: U4.37, U10.13
/PREDM2: U4.36, U10.6
/PREDM3: U4.35, U10.14
/PREDQ0: RN1.2, U3.46, U7.7
/PREDQ1: RN1.3, U3.45, U7.13
/PREDQ2: RN1.4, U3.44, U7.6
/PREDQ3: RN1.5, U3.43, U7.14
/PREDQ4: RN1.6, U3.42, U7.5
/PREDQ5: RN1.7, U3.41, U7.15
/PREDQ6: RN1.8, U3.40, U7.4
/PREDQ7: RN1.9, U3.39, U7.16
/PREDQ8: RN2.2, U3.38, U9.7
/PREDQ9: RN2.3, U3.37, U9.13
/PREDQ10: RN2.4, U3.36, U9.6
/PREDQ11: RN2.5, U3.35, U9.14
/PREDQ12: RN2.6, U3.34, U9.5
/PREDQ13: RN2.7, U3.33, U9.15
/PREDQ14: RN2.8, U3.32, U9.4
/PREDQ15: RN2.9, U3.31, U9.16
/PREDQ16: RN3.2, U3.30, U11.7
/PREDQ17: RN3.3, U3.29, U11.13
/PREDQ18: RN3.4, U3.28, U11.6
/PREDQ19: RN3.5, U3.27, U11.14
/PREDQ20: RN3.6, U3.26, U11.5
/PREDQ21: RN3.7, U3.25, U11.15
/PREDQ22: RN3.8, U5.46, U11.4
/PREDQ23: RN3.9, U5.45, U11.16
/PREDQ24: RN4.2, U5.44, U13.7
/PREDQ25: RN4.3, U5.43, U13.13
/PREDQ26: RN4.4, U5.42, U13.6
/PREDQ27: RN4.5, U5.41, U13.14
/PREDQ28: RN4.6, U5.40, U13.5
/PREDQ29: RN4.7, U5.39, U13.15
/PREDQ30: RN4.8, U5.38, U13.4
/PREDQ31: RN4.9, U5.37, U13.16
/PREDQS0: RN5.2, U1.5, U5.36, U8.7
/PREDQS1: RN5.4, U1.9, U5.34, U8.13
/PREDQS2: RN5.6, U1.11, U5.32, U8.6
/PREDQS3: RN5.8, U1.13, U5.30, U8.14
/PREDQS4: RN6.2, U2.1, U5.28, U8.5
/PREDQS5: RN6.4, U2.3, U5.26, U8.15
/PREDQS6: RN6.6, U2.5, U4.46, U8.4
/PREDQS7: RN6.8, U2.9, U4.44, U8.16
/PREODT: A1.14, U6.30
/PRESA0: A1.23, U6.32
/PRESA1: A1.24, U6.31
/PRESCL: A1.22, U6.33
/PRESDA: A1.21, R12.2, U6.34
/SA0: J1.198, U6.17
/SA1: J1.200, U6.18
/SCL: J1.197, U6.16
/SDA: J1.195, R11.2, U6.15
/SHIFT_CLK: A1.10, U7.12, U8.12, U9.12, U10.12, U11.12, U12.12, U13.12, U14.12
/SHIFT_INPUT: A1.5, U7.11
/SHIFT_OUT0: U7.17, U9.11
/SHIFT_OUT1: U9.17, U11.11
/SHIFT_OUT2: U11.17, U13.11
/SHIFT_OUT3: U8.11, U13.17
/SHIFT_OUT4: U8.17, U10.11
/SHIFT_OUT5: U10.17, U12.11
/SHIFT_OUT6: U12.17, U14.11
/SHIFT_OUTPUT: A1.6, U14.17
/SHIFT_S0: A1.7, U7.1, U8.1, U9.1, U10.1, U11.1, U12.1, U13.1, U14.1
/SHIFT_S1: A1.8, U7.19, U8.19, U9.19, U10.19, U11.19, U12.19, U13.19, U14.19
/VDDSPD: J1.199, R11.1
/VREF: J1.1, R9.2, R10.1
/~CAS: J1.113, U6.12
/~CK0: J1.32, U4.8
/~CK1: J1.166, U4.10
/~DQS0: J1.11, U5.14
/~DQS1: J1.29, U5.16
/~DQS2: J1.49, U5.18
/~DQS3: J1.68, U5.20
/~DQS4: J1.129, U5.22
/~DQS5: J1.146, U5.24
/~DQS6: J1.167, U4.4
/~DQS7: J1.186, U4.6
/~PRECAS: A1.13, U6.37
/~PRECK0: U1.2, U4.41
/~PRECK1: U1.4, U4.39
/~PREDQS0: RN5.3, U1.6, U5.35
/~PREDQS1: RN5.5, U1.8, U5.33
/~PREDQS2: RN5.7, U1.10, U5.31
/~PREDQS3: RN5.9, U1.12, U5.29
/~PREDQS4: RN6.3, U2.2, U5.27
/~PREDQS5: RN6.5, U2.4, U5.25
/~PREDQS6: RN6.7, U2.6, U4.45
/~PREDQS7: RN6.9, U2.8, U4.43
/~PRERAS: A1.12, U6.38
/~PRES0: U6.36, U14.15
/~PRES1: U6.35, U14.4
/~PREWE: A1.11, U6.39
/~RAS: J1.108, U6.11
/~S0: J1.110, U6.13
/~S1: J1.115, U6.14
/~SHIFT_OE: A1.9, U7.2, U7.3, U8.2, U8.3, U9.2, U9.3, U10.2, U10.3, U11.2, U11.3, U12.2, U12.3, U13.2, U13.3, U14.2, U14.3
/~WE: J1.109, U6.10
GND: A1.4, A1.29, C1.1, C2.1, C3.1, C4.1, C5.1, C6.1, C7.1, C8.1, C9.1, C10.1, C11.1, C12.1, C13.1, C14.1, GND1.1, J1.2, J1.3, J1.8, J1.9, J1.12, J1.15, J1.18, J1.21, J1.24, J1.27, J1.28, J1.33, J1.34, J1.39, J1.40, J1.41, J1.42, J1.47, J1.48, J1.53, J1.54, J1.59, J1.60, J1.65, J1.66, J1.71, J1.72, J1.77, J1.78, J1.121, J1.122, J1.127, J1.128, J1.132, J1.133, J1.138, J1.139, J1.144, J1.145, J1.149, J1.150, J1.155, J1.156, J1.161, J1.162, J1.165, J1.168, J1.171, J1.172, J1.177, J1.178, J1.183, J1.184, J1.187, J1.190, J1.193, J1.196, R10.2, U1.7, U2.7, U2.11, U2.13, U3.1, U4.1, U5.1, U6.1, U7.10, U7.18, U8.10, U8.18, U9.10, U9.18, U10.10, U10.18, U11.10, U11.18, U12.10, U12.18, U13.10, U13.18, U14.10, U14.18
unnamed: C3.2, R2.2, U3.47, U3.48
unnamed: C4.2, R4.2, U4.47, U4.48
unnamed: C5.2, R6.2, U5.47, U5.48
unnamed: C6.2, R8.2, U6.47, U6.48
unnamed: R1.2, R2.1
unnamed: R3.2, R4.1
unnamed: R5.2, R6.1
unnamed: R7.2, R8.1
VCC: A1.27, C1.2, C2.2, C7.2, C8.2, C9.2, C10.2, C11.2, C12.2, C13.2, C14.2, R1.1, R3.1, R5.1, R7.1, R12.1, RN1.1, RN2.1, RN3.1, RN4.1, RN5.1, RN6.1, U1.14, U2.14, U7.9, U7.20, U8.9, U8.20, U9.9, U9.20, U10.9, U10.20, U11.9, U11.20, U12.9, U12.20, U13.9, U13.20, U14.9, U14.20, VCC5V1.1
