Edgeworth/memepu/test_data/memecad/full_adder.sch

## KiCad design test_data/memecad/full_adder.sch (2019-03-31)

Schematic: full_adder.sch

Parts:
C1, C2, C3, C4, C5, C6, C7, C8, C9, C10: C_Small; C_Disc_D7.5mm_W2.5mm_P5.00mm
U1, U2, U3, U4: 74HC86; DIP-14_W7.62mm
U5, U6, U7, U8: 74LS08; DIP-14_W7.62mm
U9, U10: 74LS32; DIP-14_W7.62mm

Notes on the sheet:
Multiline test string
TEXT TEST
