Edgeworth/memepu/verymeme/verilog/tapb_top_level.v

`include "common.v"

module tapb_top_level(
  input wire [3:0] LOW_B
);
  logic [7:0] out;
  two_a_plus_b tapb(.A(8'd42), .B({4'b1010, LOW_B}), .OUT(out));

  `ifdef FORMAL
  always_comb begin
    assert (out == 8'd105);
  end
  `endif
endmodule
