Edgeworth/memepu/src/memecad/yosys_module.cpp

// Copyright 2019 Eliot Courtney.
#include "memecad/yosys_module.h"

#include <algorithm>
#include <string>
#include <unordered_map>
#include <vector>

#include "kernel/sigtools.h"
#include "memecad/parser.h"
#include "verymeme/file.h"
#include "verymeme/macros.h"

namespace memecad {
USING_YOSYS_NAMESPACE

namespace {

constexpr const char* PASS_NAME = "memecad";

std::vector<Lib> parseLibraries(const std::vector<std::string>& filenames) {
  std::vector<Lib> libs;
  for (const auto& filename : filenames)
    libs.push_back(parseLibrary(readFile(filename), stem(filename)));
  return libs;
}

}  // namespace

std::vector<Schematic::SchematicFile> convertVerilogToKicadSchematics(
    const std::string& memecad_map_filename, std::vector<string> verilog_filenames,
    std::vector<string> kicad_library_filenames) {
  static bool has_setup_yosys = false;
  static memecad::TestPass test_pass;

  // Some ordering (e.g. order of packing components into schematics) can be affected by filename
  // order, so sort here to keep things consistent.
  std::sort(verilog_filenames.begin(), verilog_filenames.end());
  std::sort(kicad_library_filenames.begin(), kicad_library_filenames.end());

  Yosys::autoidx = 1;  // Reset the indexing so we get the same output each time.
  if (!has_setup_yosys) {
    Yosys::log_streams.push_back(&std::cout);
    Yosys::log_error_stderr = true;
    Yosys::yosys_banner();
    Yosys::yosys_setup();
    has_setup_yosys = true;
  }
  Yosys::run_pass("delete *");  // Delete any old modules etc from previous runs.
  std::string yosys_cmd = "read -sv -D SCHEMATIC";  // Automatically define SCHEMATIC.
  for (const auto& filename : verilog_filenames) yosys_cmd += " " + filename;
  Yosys::run_pass(yosys_cmd);
  // Check all needed files exist. Also adjusts the port width so you can e.g. pass 32 bit
  // constant to a single bit port.
  Yosys::run_pass("hierarchy -check");
  Yosys::run_pass("check");  // Check for misc problems.
  Yosys::run_pass("chparam");  // Create modules properly.
  test_pass.setup(memecad_map_filename, kicad_library_filenames);
  Yosys::run_pass(PASS_NAME);

  return test_pass.mapper().schematic().writeHierarchy();
}

TestPass::TestPass() : Pass(PASS_NAME) {}

void TestPass::setup(const std::string& memecad_map_filename,
    const std::vector<std::string>& kicad_library_filenames) {
  mapper_ = Mapper(readFile(memecad_map_filename), parseLibraries(kicad_library_filenames));
}

void TestPass::execute(std::vector<std::string> args, Design* design) {
  log_header(design, "Extracting modules...\n");
  extra_args(args, 1, design);

  std::unordered_map<Module*, std::vector<Module*>> adj;
  std::unordered_map<Module*, int> incoming;
  for (auto& module_iter : design->modules_) {
    const auto& [module_id, module] = module_iter;
    if (!design->selected_module(module)) continue;

    printModuleInfo(module);

    // Generate kicad sheet for this module.
    if (!mapper_.isMappedModule(*module)) {
      printf("Processing module: %s\n", log_id(module_id));
      for (auto& cell_iter : module->cells_) {
        const auto& [cell_id, cell] = cell_iter;
        printf("  Checking child '%s'\n", cell_id.c_str());

        // Add edge from child to parent, for reverse top-sort.
        auto* child_module = design->module(moduleType(*cell));
        verify(child_module != nullptr, "expected module %s' to exist", moduleType(*cell).c_str());

        if (mapper_.isMappedModule(*child_module)) continue;  // Don't need to process leaf modules.
        adj[child_module].push_back(module);
        printf("  Adding child '%s' to module '%s'\n", cell_id.c_str(), log_id(module_id));
        incoming[module]++;  // Parent module has incoming edge.
      }
    } else {
      printf("Skipping leaf module '%s'\n", log_id(module_id));
    }
  }

  std::vector<Module*> next;
  for (auto& kv : design->modules_) {
    if (!mapper_.isMappedModule(*kv.second) && incoming[kv.second] == 0) next.push_back(kv.second);
  }

  // Topological sort.
  int num_processed = 0;
  while (!next.empty()) {
    Module* module = next.back();
    next.pop_back();
    num_processed++;

    printModuleInfo(module);
    mapper_.addModule(*module);
    for (auto& cell_iter : module->cells_) {
      const auto& [cell_id, cell] = cell_iter;
      mapper_.addCell(*cell);
    }

    // Add new nodes with no incoming edges.
    for (auto* child : adj[module]) {
      incoming[child]--;
      if (incoming[child] == 0) next.push_back(child);
    }
  }
  bug_unless(num_processed == static_cast<int>(adj.size()));
}

void TestPass::printModuleInfo(Yosys::RTLIL::Module* module) {
  SigMap sigmap(module);
  log("Module %s\n", log_id(module->name));

  for (auto& cell_iter : module->cells_) {
    const auto& [cell_id, cell] = cell_iter;
    log("  Cell %s, name: %s, module: %s\n    type: %s\n", cell_id.c_str(), cell->name.c_str(),
        cell->module->name.c_str(), cell->type.c_str());
    for (auto& conn : cell->connections()) {
      const auto& sig = sigmap(conn.second);
      log("    Connection: %s, signal: %s|%d\n", conn.first.c_str(), log_signal(sig), sig.size());
    }
  }

  log("  Wires:\n");
  for (auto& wire_iter : module->wires_) {
    const auto& [wire_id, wire] = wire_iter;
    log("    Wire %s, start offset: %d, port id: %d\n", wire_id.c_str(), wire->start_offset,
        wire->port_id);
  }
  log("\n");

  log("  Module connections:\n");
  for (auto& sigsig : module->connections()) {
    log("   %s (size: %d) <=> %s (size: %d)\n", log_signal(sigsig.first), sigsig.first.size(),
        log_signal(sigsig.second), sigsig.second.size());
  }
  log("\n");
}

}  // namespace memecad
