Edgeworth/memepu/verilog/chip7400.v

// Copyright 2019 Eliot Courtney.
`include "common.v"

// NAND
module chip7400(
  input wire [3:0] A,
  input wire [3:0] B,
  output logic [3:0] Y
);
  assign Y = ~(A & B);

  `ifdef FORMAL
  always_comb begin
    assert (Y == ~(A & B));
  end
  `endif
endmodule
