Edgeworth/memepu/verilog/chip7404.v

// Copyright 2019 Eliot Courtney.
`include "common.v"

// NOT
module chip7404(
  input wire [5:0] A,
  output logic [5:0] Y
);
  assign Y = ~A;

  `ifdef FORMAL
  always_comb begin
    assert (Y == ~A);
  end
  `endif
endmodule
