Edgeworth/memepu/verilog/chip74107.v

// Copyright 2019 Eliot Courtney.
`include "common.v"

// JK-flipflop, negative edge trigger.
module chip74107(
  input wire [1:0] J,
  input wire [1:0] K,
  input wire [1:0] N_CP,
  input wire [1:0] N_R,
  output logic [1:0] Q,
  output logic [1:0] N_Q
);
  generate
    genvar i;
    for (i = 0; i < 2; i = i+1) begin
      logic data;

      assign Q[i] = data;
      assign N_Q[i] = ~data;

      // Make sure async reset works on startup for verilator.
      `ifdef verilator
      initial begin
        if (!N_R[i]) data = 0;
      end
      `endif

      always_ff @(negedge N_CP[i] or negedge N_R[i]) begin
        if (!N_R[i]) data <= 0;
        else begin
          if (J[i] && K[i]) data <= !data;
          else if (J[i] || K[i]) data <= J[i];
          else data <= data;
        end
      end

      `ifdef FORMAL
      integer f_past;
      initial f_past = 0;

      always_ff @($global_clock) begin
        if (!N_R[i]) f_past <= 0;
        else f_past <= 1;

        if (f_past && N_R[i]) begin
          if ($fell(N_CP[i])) begin
            if ($past(J[i]) && $past(K[i])) assert (data != $past(data));
            else if ($past(J[i])) assert (data);
            else if ($past(K[i])) assert (!data);
            else assert (data == $past(data));
          end
        end
      end

      always_comb begin
        assert (Q[i] != N_Q[i]);
        if (!N_R[i]) assert (!Q[i] && N_Q[i]);
      end
      `endif
    end
  endgenerate
endmodule
