Edgeworth/memepu/(commit log)

2018-05-14 Initial commit.
    [clock.sch, cpu.kicad_pcb, cpu.sch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]
2018-05-16 Add manual bus. Do layout stuff.
    [clock.sch, cpu.kicad_pcb, cpu.sch, manual_bus.sch]
2018-05-16 Think about design. Add A and B registers to schematic and pcb.
    [bus_leds.sch, clock.sch, cpu.dsn, cpu.kicad_pcb, cpu.sch, manual_bus.sch, register.sch, registers.sch]
2018-05-16 Add M0-2 registers
    [bus_leds.sch, clock.sch, cpu.sch, manual_bus.sch, register.sch, registers.sch]
2018-05-16 Fix bug
    [register.sch]
2018-05-16 Add micro-usb
    [bus_leds.sch, cpu.kicad_pcb, cpu.sch, register.sch]
2018-05-16 Remove register LEDs
    [bus_leds.sch, clock.sch, cpu.kicad_pcb, cpu.sch, manual_bus.sch, register.sch, registers.sch]
2018-05-16 Remove bus transceivers from registers, as they are no longer connected to LEDs.
    [cpu.kicad_pcb, cpu.sch, register.sch]
2018-05-17 Add bus transceivers back just for registers A and B, so they can be connected to the ALU. Add ALU to schematic.
    [alu.sch, bus_leds.sch, clock.sch, cpu.sch, manual_bus.sch, register.sch, register_with_bus_transceiver.sch, registers.sch]
2018-05-17 Add display module. Still need to check if it needs resistors.
    [alu.sch, bus_leds.sch, clock.sch, cpu.dsn, cpu.kicad_pcb, cpu.sch, display_module.sch, manual_bus.sch]
2018-05-17 Import display module into PCB.
    [cpu.kicad_pcb]
2018-05-19 Going to change design to use 16 MHz crystal, with frequency dividers. Also, control EEPROM output will be latched, and computed on the rising edge instead of the falling edge.
    [cpu.kicad_pcb, display_module.sch]
2018-05-19 Add clock glitch fixer.
    [clock.sch, cpu.sch]
2018-05-22 Update notes. Layout extra clock stuff.
    [clock.sch, register.sch]
2018-05-24 Start program counter. Write down design notes.
    [alu.sch, bus_leds.sch, clock.sch, cpu.dsn, cpu.kicad_pcb, cpu.sch, display_module.sch, manual_bus.sch]
2018-05-24 Add SC register and program counter.
    [alu.sch, cpu.sch, program_counter.sch, register.sch, register_with_bus_transceiver.sch, sc_register.sch]
2018-05-24 Schematic for kernel and user stack pointers.
    [alu.sch, bus_leds.sch, clock.sch, cpu.kicad_pcb, cpu.sch, display_module.sch, manual_bus.sch, mlu.sch]
2018-05-26 Layout user and kernel stack pointers.
    [cpu.kicad_pcb, stack_register.sch]
2018-05-26 Initial MMU plan. Need to change task register and add memory protection.
    [alu.sch, bus_leds.sch, clock.sch, cpu.sch, display_module.sch, manual_bus.sch, mlu.sch, mmu.sch]
2018-05-28 Finish MMU schematic.
    [cpu.sch, mmu.sch, register.sch, register_with_bus_transceiver.sch, registers.sch, stack_register.sch]
2018-05-28 Layout MMU.
    [cpu.kicad_pcb, cpu.sch, mmu.sch, register.sch, stack_register.sch]
2018-05-28 Progress on control logic. Write xdotool automation script.
    [5_32_decoder.sch, alu.sch, bus_leds.sch, clk_and.sch, clock.sch, control_logic.sch, cpu.dsn, cpu.kicad_pcb]
2018-05-28 Small progress.
    [clock.sch, control_logic.sch, cpu.kicad_pcb, cpu.sch]
2018-05-29 Progress on control logic. Micro-op counter. Opcode register.
    [5_32_decoder.sch, alu.sch, bus_leds.sch, clk_and.sch, clock.sch, control_logic.sch, cpu.sch, display_module.sch]
2018-05-31 Small fixes.
    [control_logic.sch]
2018-05-31 Control logic progress.
    [5_32_decoder.sch, alu.sch, bus_leds.sch, clk_and.sch, clock.sch, control_logic.sch, cpu.sch, display_module.sch]
2018-06-02 Start connecting up control logic.
    [control_logic.sch, cpu.sch, mmu.sch]
2018-06-02 Fix PC INC, SP, KSP inc/dec.
    [5_32_decoder.sch, alu.sch, bus_leds.sch, clk_and.sch, clock.sch, control_logic.sch, cpu.sch, display_module.sch]
2018-06-02 Small updates.
    [clk_and.sch, cpu.sch, stack_register.sch]
2018-06-02 Remove manual bus input from schematic.
    [5_32_decoder.sch, alu.sch, bus_leds.sch, clk_and.sch, clock.sch, control_logic.sch, cpu.sch, display_module.sch]
2018-06-02 Reset related progress.
    [alu.sch, clk_and.sch, clock.sch, control_logic.sch, cpu.sch, microop_counter.sch, opcode_register.sch, program_counter.sch]
2018-06-02 Small update.
    [5_32_decoder.sch, clk_and.sch, clock.sch, control_logic.sch, cpu.sch, register.sch, register_with_bus_transceiver.sch, sc_register.sch]
2018-06-02 Import into pcbnew.
    [5_32_decoder.sch, clk_and.sch, clock.sch, control_logic.sch, cpu.sch, flag_logic.sch, register.sch, register_with_bus_transceiver.sch]
2018-06-02 Layout progress.
    [5_32_decoder.sch, clk_and.sch, control_logic.sch, cpu.kicad_pcb, flag_logic.sch, register_with_bus_transceiver.sch]
2018-06-03 Add control logic LEDs to schematic.
    [5_32_decoder.sch, alu.sch, bus_leds.sch, clk_and.sch, clock.sch, control_logic.sch, control_logic_leds.sch, cpu.kicad_pcb]
2018-06-03 Going to try out resistor network.
    [control_logic.sch, control_logic_leds.sch, register.sch]
2018-06-03 Change to resistor networks for LEDs.
    [bus_leds.sch, control_logic_leds.sch, cpu.kicad_pcb, register.sch]
2018-06-03 Fix LEDs a bit.
    [clk_and.sch, control_logic.sch, control_logic_leds.sch, cpu.sch, mlu.sch]
2018-06-03 Aux board connector.
    [clk_and.sch, cpu.sch]
2018-06-04 Update layout.
    [cpu.kicad_pcb]
2018-06-06 Small layout changes.
    [5_32_decoder.sch, _saved_clock.sch, clk_and.sch, clock.sch, cpu.kicad_pcb, register_with_bus_transceiver.sch]
2018-06-08 Layout changes to optimise routing.
    [5_32_decoder.sch, alu.sch, bus_leds.sch, clk_and.sch, clock.sch, control_logic.sch, control_logic_leds.sch, cpu.dsn]
2018-06-08 Checkpoint. Trying spacing everything out a bit.
    [cpu.dsn]
2018-06-08 Moved resistor network I forgot.
    [cpu.kicad_pcb]
2018-06-09 Decided to remove LEDs.
    [cpu.dsn, cpu.kicad_pcb]
2018-06-10 Removed LEDs. Layout changes.
    [5_32_decoder.sch, alu.sch, clk_and.sch, clock.sch, control_logic.sch, cpu.dsn, cpu.kicad_pcb, cpu.sch]
2018-06-10 Getting close to final layout.
    [cpu.dsn, cpu.kicad_pcb]
2018-06-10 Starting to finish up layout.
    [cpu.dsn, cpu.kicad_pcb]
2018-06-10 Mostly done.
    [cpu.dsn, cpu.kicad_pcb]
2018-06-10 Added script. Snapped all components to .5mm boundary.
    [cpu.dsn, cpu.kicad_pcb]
2018-06-10 Update script.
    [clock.sch, cpu.kicad_pcb]
2018-06-12 Update layout with new capacitor sizes, etc.
    [5_32_decoder.sch, alu.sch, clk_and.sch, clock.sch, control_logic.sch, cpu.dsn, cpu.kicad_pcb, cpu.sch]
2018-06-12 Layout tweaks.
    [cpu.dsn, cpu.kicad_pcb]
2018-06-12 Improve silkscreen.
    [control_logic.sch, cpu.dsn, cpu.kicad_pcb, stack_register.sch]
2018-06-14 Final layout ?
    [cpu-B.Cu.gbr, cpu-B.Mask.gbr, cpu-B.Paste.gbr, cpu-B.SilkS.gbr, cpu-Edge.Cuts.gbr, cpu-F.Cu.gbr, cpu-F.Mask.gbr, cpu-F.Paste.gbr]
2018-06-21 Fix backwards clock indicator LEDs.
    [5_32_decoder.sch, clock.sch, register.sch]
2018-06-21 Reduce clock LED brightness.
    [clock.sch]
2018-06-23 Fix adjustable clock resistor to be in series not parallel.
    [clock.sch]
2018-06-25 Start writing control logic.
    [cpu-B.Cu.gbr, cpu-B.Mask.gbr, cpu-B.Paste.gbr, cpu-B.SilkS.gbr, cpu-Edge.Cuts.gbr, cpu-F.Cu.gbr, cpu-F.Mask.gbr, cpu-F.Paste.gbr]
2018-06-26 Fix arduino d13 LED pullup bug.
    [eeprom_programmer.kicad_pcb, eeprom_programmer.sch]
2018-06-28 Update symbol in EEPROM pcb.
    [eeprom_programmer.sch]
2018-07-09 Write assembler. Write fibonacci assembly. Reorganise.
2018-07-13 Progress on control logic.
    [5_32_decoder.sch, cpu.kicad_pcb, microop_counter.sch, mmu.sch, program_counter.sch]
2018-07-18 Found bug. Control logic progress.
    [5_32_decoder.sch, cpu.kicad_pcb, cpu.sch, register.sch, register_with_bus_transceiver.sch, sc_register.sch]
2018-07-21 Interrupt stuff.
2018-07-21 Fix bug in labels.
    [5_32_decoder.sch, alu.sch, clk_and.sch, clock.sch, control_logic.sch, cpu.sch, display_module.sch, flag_logic.sch]
2018-07-22 Update symbols.
    [5_32_decoder.sch, alu.sch, clk_and.sch, clock.sch, control_logic.sch, cpu.sch, display_module.sch, flag_logic.sch]
2018-07-22 Fix interrupt lines connected to the wrong thing.
    [5_32_decoder.sch, alu.sch, clk_and.sch, clock.sch, control_logic.sch, cpu.sch, display_module.sch, flag_logic.sch]
2018-07-22 Copy PCB to pcb_v1 for old version (modulo some changes). Remove Kernel Stack Pointer from new version.
    [5_32_decoder.sch, alu.sch, bus_leds.sch, clk_and.sch, clock.sch, control_logic.sch, control_logic_leds.sch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]
2018-07-22 Removed opcode increment functionality. Can just use bus output instead.
    [clk_and.sch, control_logic.sch, opcode_register.sch, register.sch]
2018-07-22 Add offsets specifiable in the assembler.
2018-07-22 Ability to dump state to connected test Arduino.
2018-07-22 Do a first pass in the assembler so we can reference labels defined later in the file.
2018-08-06 Use OR + not with NCLK for stack pointer and MMU_IN and MMU_CONTROL_IN (latter still not hooked up). Reduces number of chips.
    [5_32_decoder.sch, alu.sch, clk_and.sch, clk_or.sch, clock.sch, control_logic.sch, cpu.sch, display_module.sch]
2018-08-06 Make ~MMU_CONTROL_IN by using spare clock ander and spare not.
    [clk_and.sch, clk_or.sch, clock.sch, control_logic.sch, cpu.sch, register.sch, register_with_bus_transceiver.sch, stack_register.sch]
2018-08-06 Improve convention for spares. SPARE TAKEN and SPARE AVAILABLE.
    [alu.sch, clock.sch, control_logic.sch, cpu.sch, sc_register.sch, stack_register.sch]
2018-08-06 Footprint assignment.
    [clk_or.sch, control_logic.sch, display_module.sch, mlu.sch, mmu.sch]
2018-08-06 Update PCB.
    [cpu.kicad_pcb]
2018-08-07 Interrupts fully working
2018-08-10 Remove clock LEDs.
    [clock.sch]
2018-08-10 Replace frequency counters with 74HC590.
    [clock.sch]
2018-08-10 Feed display module clock from frequency divider in clock logic, not separate 555 timer.
    [clock.sch, cpu.sch, display_module.sch]
2018-08-10 Remove now useless 'Gnd' and 'Vcc' labels for one part of the clock.
    [clock.sch, display_module.sch]
2018-08-10 Pull interrupt lines low.
    [cpu.sch]
2018-08-10 Replace stack pointer with plain registers. Will use MLU to do increment/decrement.
    [5_32_decoder.sch, alu.sch, clk_and.sch, clk_or.sch, clock.sch, control_logic.sch, cpu.sch, display_module.sch]
2018-08-10 Clean up stack register file.
    [cpu-B.Cu.gbr, cpu-B.Mask.gbr, cpu-B.Paste.gbr, cpu-B.SilkS.gbr, cpu-Edge.Cuts.gbr, cpu-F.Cu.gbr, cpu-F.Mask.gbr, cpu-F.Paste.gbr]
2018-08-10 Change PC to be regular registers, not a counter.
    [5_32_decoder.sch, alu.sch, clk_and.sch, clk_or.sch, clock.sch, control_logic.sch, cpu.sch, display_module.sch]
2018-08-10 Cleanup program counter.
    [control_logic.sch, cpu.sch, program_counter.sch]
2018-08-10 Rewiring for PC and stack pointer after changing them to regular registers.
    [5_32_decoder.sch, alu.sch, clk_and.sch, clk_or.sch, clock.sch, control_logic.sch, cpu.sch, display_module.sch]
2018-08-10 Remove ALU. Will use MLU to do computations from now on. This also removes the ALU status bits, carry and zero. We can get these from a special MLU status operation instead.
    [5_32_decoder.sch, alu.sch, clk_and.sch, clk_or.sch, clock.sch, control_logic.sch, cpu.sch, display_module.sch]
2018-08-11 Switch to active high outputs on the IN plane decoder - this removes the inverters. Wire the CLK signal into the enable inputs on these chips - this removes all the CLK anders.
    [5_32_decoder.sch, clk_and.sch, clk_or.sch, clock.sch, control_logic.sch, cpu.kicad_pcb, cpu.sch, display_module.sch]
2018-08-11 Replace opcode registers with regular registers. However, use 74HC273 which has a bad pinout but main reset instead of output enable.
    [5_32_decoder.sch, clock.sch, control_logic.sch, cpu.sch, display_module.sch, flag_logic.sch, in_plane_decoder.sch, microop_counter.sch]
2018-08-11 Reduce multi-plane size from 4-16 to 3-8. Then, output CTRL bus output using output enable on the control latch register instead of using a separate bus transceiver, since MLU mode select no longer o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
    [clock.sch, control_logic.sch, cpu.kicad_pcb, in_plane_decoder.sch]
2018-08-11 Increase micro-op counter to 5 bit.
    [control_logic.sch, flag_logic.sch, microop_counter.sch, register.sch]
2018-08-11 Create display mode register. Don't use dip switches to change display mode.
    [5_32_decoder.sch, clock.sch, control_logic.sch, cpu.kicad_pcb, cpu.sch, display_module.sch, flag_logic.sch, in_plane_decoder.sch]
2018-08-11 Fixed bug where memory mapped EEPROM would output on M20 low instead of high. Replaced 4-16 line decoder in MMU with 3-8 line decoder.
    [control_logic.sch, cpu.sch, mmu.sch, register.sch]
2018-08-11 Replace 10K resistor in adjustable clock with 1K resistor to make it faster.
    [clock.sch, cpu.sch]
2018-08-11 Add INT_IN_CLK signal to latch current interrupts.
    [control_logic.sch, cpu.sch, register.sch, sc_register.sch]
2018-08-11 Some layout.
    [cpu.kicad_pcb, in_plane_decoder.sch, register.sch]
2018-08-31 Add memelang.
    [cpu.kicad_pcb]
2018-09-02 Remove obsolete eeprom programmer project.
    [eeprom_programmer.kicad_pcb, eeprom_programmer.sch]
2018-09-16 Work on moving everything to 32 bit + proper paging + memory mapped IO.
    [5_32_decoder.sch, address_register.sch, alu.sch, clock.sch, control_logic.sch, cpu.kicad_pcb, cpu.sch, display_module.sch]
2018-09-17 Conversion to 32-bit word mostly done?
    [alu.sch, clock.sch, control_logic.sch, cpu.kicad_pcb, cpu.sch, in_plane_decoder.sch, mmu.sch, register.sch]
2018-09-21 About to try reducing by 1 EEPROM and reducing number of chips.
    [5_32_decoder.sch, control_logic.sch, cpu.kicad_pcb, register_one_byte.sch]
2018-09-21 Remove unneeded files.
    [bus_leds.sch, control_logic_leds.sch, flag_logic.sch, interrupt_logic.sch, mlu.sch]
2018-09-21 Removed 1 EEPROM and some other chips by moving BUS_OUT signals to multi-plane.
    [5_32_decoder.sch, alu.sch, clock.sch, control_logic.sch, cpu.kicad_pcb, cpu.sch, out_plane_decoder.sch, register.sch]
2018-09-21 Small changes.
    [clock.sch, cpu.kicad_pcb, cpu.sch, register_one_byte.sch]
2018-09-21 Added traces for bypass caps and locked trackes.
    [cpu.kicad_pcb]
2018-09-22 Add copy of pcb, pcb_smd. New smd project?
    [address_register.sch, alu.sch, clock.sch, control_logic.sch, cpu.kicad_pcb, cpu.sch, in_plane_decoder.sch, microop_counter.sch]
2018-10-06 Move stuff around.
    [5_32_decoder.sch, address_register.sch, alu.sch, bus_leds.sch, clk_and.sch, clock.sch, control_logic.sch, control_logic_leds.sch]
2018-11-25 Reorganise + start dram test project.
    [5_32_decoder.sch, address_register.sch, alu.sch, bus_leds.sch, clk_and.sch, clock.sch, control_logic.sch, control_logic_leds.sch]
2019-01-28 Organise and progress on DRAM tester schematic.
    [5_32_decoder.sch, address_register.sch, alu.sch, bus_leds.sch, clk_and.sch, clock.sch, control_logic.sch, control_logic_leds.sch]
2019-02-09 Add full adder, test, quieter test printer.
2019-02-09 Add test kicad project
    [full_adder.sch]
2019-02-09 Add annotation and footprints to test kicad project.
    [full_adder.sch]
2019-02-11 Parsing progress.
    [full_adder.sch]
2019-02-12 Kicad output start
2019-03-10 About to refactor kicad parsing.
    [full_adder.sch]
2019-03-17 Improve schematic bin packing.
2019-03-20 Output hierarchical sheets.
    [full_adder.sch]
2019-03-21 Fix some bugs + sanitizers via ECM.
    [common.v, mapper.cpp, types.cpp, types.h]
2019-03-25 Split kicad schematic related code into a separate file.
2019-03-26 Schematic generation almost done.
2019-03-26 Cleanup + fix bug with global label direction.
    [full_adder.sch]
2019-03-27 Add schematic output test.
2019-03-27 Add missing files.
    [full_adder.sch, tapb_top_level.sch, two_a_plus_b.sch]
2019-03-28 Implement no-connect via verilog signals whose name starts with 'unused'.
    [full_adder.sch, tapb_top_level.sch, two_a_plus_b.sch]
2019-03-28 Change verilog module outputs from wire to logic.
2019-03-31 Support multiple libraries. Sort kicad output. Update tests.
    [full_adder.sch, tapb_top_level.sch, two_a_plus_b.sch]
2019-03-31 ALU schematic generation mostly working.
2019-03-31 Add ALU schematic generation test.
    [alu.sch, alu_lookahead.sch, alu_slice.sch]
2019-03-31 Adding 74LVC162244 symbol.
    [alu.sch, alu_lookahead.sch, alu_slice.sch]
2019-04-01 Started work on the shifter.
    [alu.sch, alu_lookahead.sch, alu_slice.sch]
2019-04-01 Order labels in hierarchical sheet better.
    [alu.sch]
2019-04-02 Take label size into account for kicad component packing.
    [alu.sch, alu_lookahead.sch, alu_slice.sch, full_adder.sch]
2019-04-02 Include label size for packing child sheets.
    [alu.sch, tapb_top_level.sch, two_a_plus_b.sch]
2019-04-05 Add timer
2019-04-05 Rename alu=>mlu and add test script to run with both schematic true and false.
2019-04-13 Add memeroute.
    [dram_test.kicad_pcb, dram_test.sch]
2019-04-19 Improve rendering.
    [dram_test.kicad_pcb]
2019-05-19 Fix some control logic stuff.
    [common.v, kpu.v, mlu.v, mlu_slice.v, sram.v]
2019-05-22 Add chip74238. Fix others.
    [chip74138.v, chip74139.v, chip74238.v, control_logic.v, kpu.v]
2019-05-24 Add chip74273 for 8-bit reg with async reset.
    [chip74273.v, control_logic.v, kpu.v, register_file.v]
2019-05-26 Add latch for control logic. Necessary to prevent metastability (hold outputs and input signals
    [control_logic.v]
2019-05-26 Fix verilog CMakeLists. Improve run testing script.
    [eeprom.v]
2019-05-26 Testing script now runs processes in a queue for formal verification. Fix some bugs.
    [bootstrapper.v, control_logic.v, eeprom.v, sram.v]
2019-05-26 Add initialisation condition. Fix formal verification in control logic.
    [control_logic.v, kpu.v]
2019-05-26 Add chip74107. Going to switch to async assert sync deassert reset.
    [chip74107.v, control_logic.v, kpu.v]
2019-05-26 Switch reset to async assert sync deassert.
    [buffer_mux3x8.v, control_logic.v, kpu.v, register_file.v, sram.v]
2019-06-17 Add mechanism for setting the assembly mnemonic in verilog. Memesim can use this to print out the current instruction + could be used to define a model for the assembler.
2019-06-24 Fix memesim bug + simplify microcode.v
    [microcode.v, mmu.v]
2019-06-25 Add graphical output for memesim. Split CLI, graphics, and simulator into three threads.
2019-07-15 Progress on lexer.
    [alu.sch]
2019-08-23 Fix mnemonics and enable LTO.
    [microcode.v]
2019-08-28 Add chip7474 and interrupt handling.
2019-09-08 Add afl support. Misc fixes.
    [parser.cpp, parser.h, util.cpp]
2019-09-28 Move builtin types to IDENT. Fix tests.
    [parser.cpp, parser.h]
2019-10-27 Fix bug with typelists in parser. Fix tests.
    [parser.cpp]
2019-12-31 Implement/refactor/improve: - eval() can return types; INVALID_HND vals are types. - autoreset for scopes and nested scopes. - define: - typename: name of something describing a set of types - type: 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
    [parser.cpp]
2020-01-01 Reorganise test data.
    [alu.sch, alu_lookahead.sch, alu_slice.sch, full_adder.sch, tapb_top_level.sch, two_a_plus_b.sch]
2020-01-25 More progress on type system. Pin googletest to 1.10.
2020-01-26 Progress on getting memecad to run on current kpu.
2021-06-20 Move some files around.
    [alu.sch, alu_lookahead.sch, alu_slice.sch, full_adder.sch, tapb_top_level.sch, two_a_plus_b.sch]
2021-06-20 run dos2unix
    [address_register.sch, alu.sch, bus_leds.sch, clock.sch, control_logic.sch, control_logic_leds.sch, cpu.kicad_pcb, cpu.sch]
2021-06-20 Move v1 out to a different repo. Lints
    [5_32_decoder.sch, address_register.sch, alu.sch, bus_leds.sch, clk_and.sch, clock.sch, control_logic.sch, control_logic_leds.sch]
